janni0609/PsLoad/Hardware/Modul/PrezisoinPowerSupply 2_5/PrezisoinPowerSupply.kicad_pcb

## KiCad design Hardware/Modul/PrezisoinPowerSupply 2_5/PrezisoinPowerSupply.kicad_pcb (2026-03-17, last stored version)

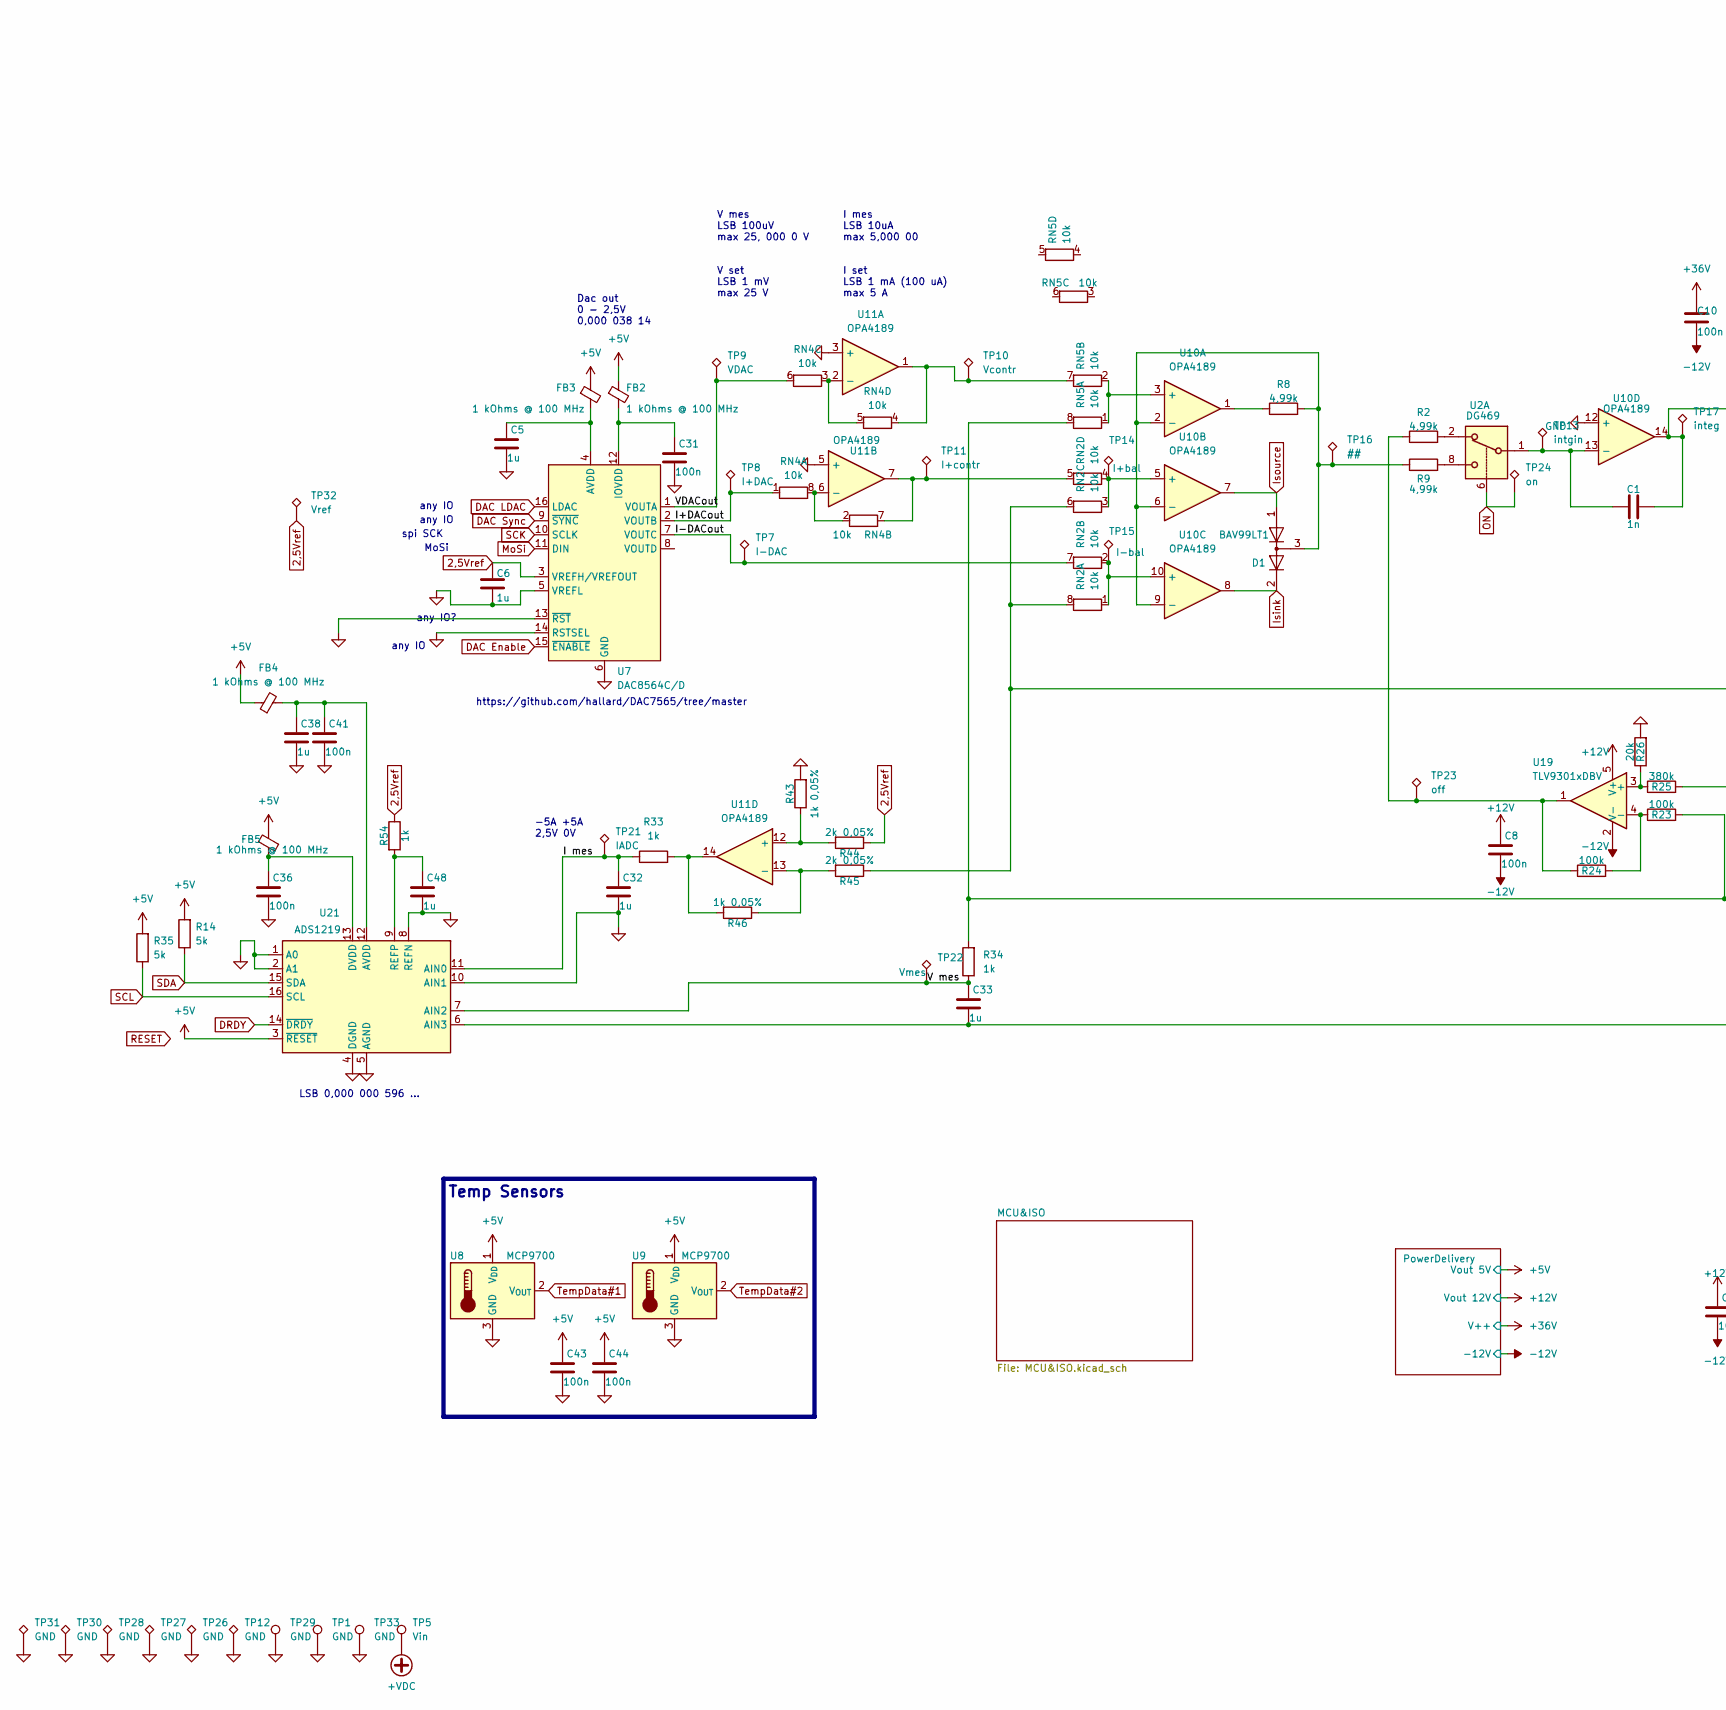
[picture p1: schematic PrezisoinPowerSupply.kicad_sch, PSLoad, part in row 1, column 1]

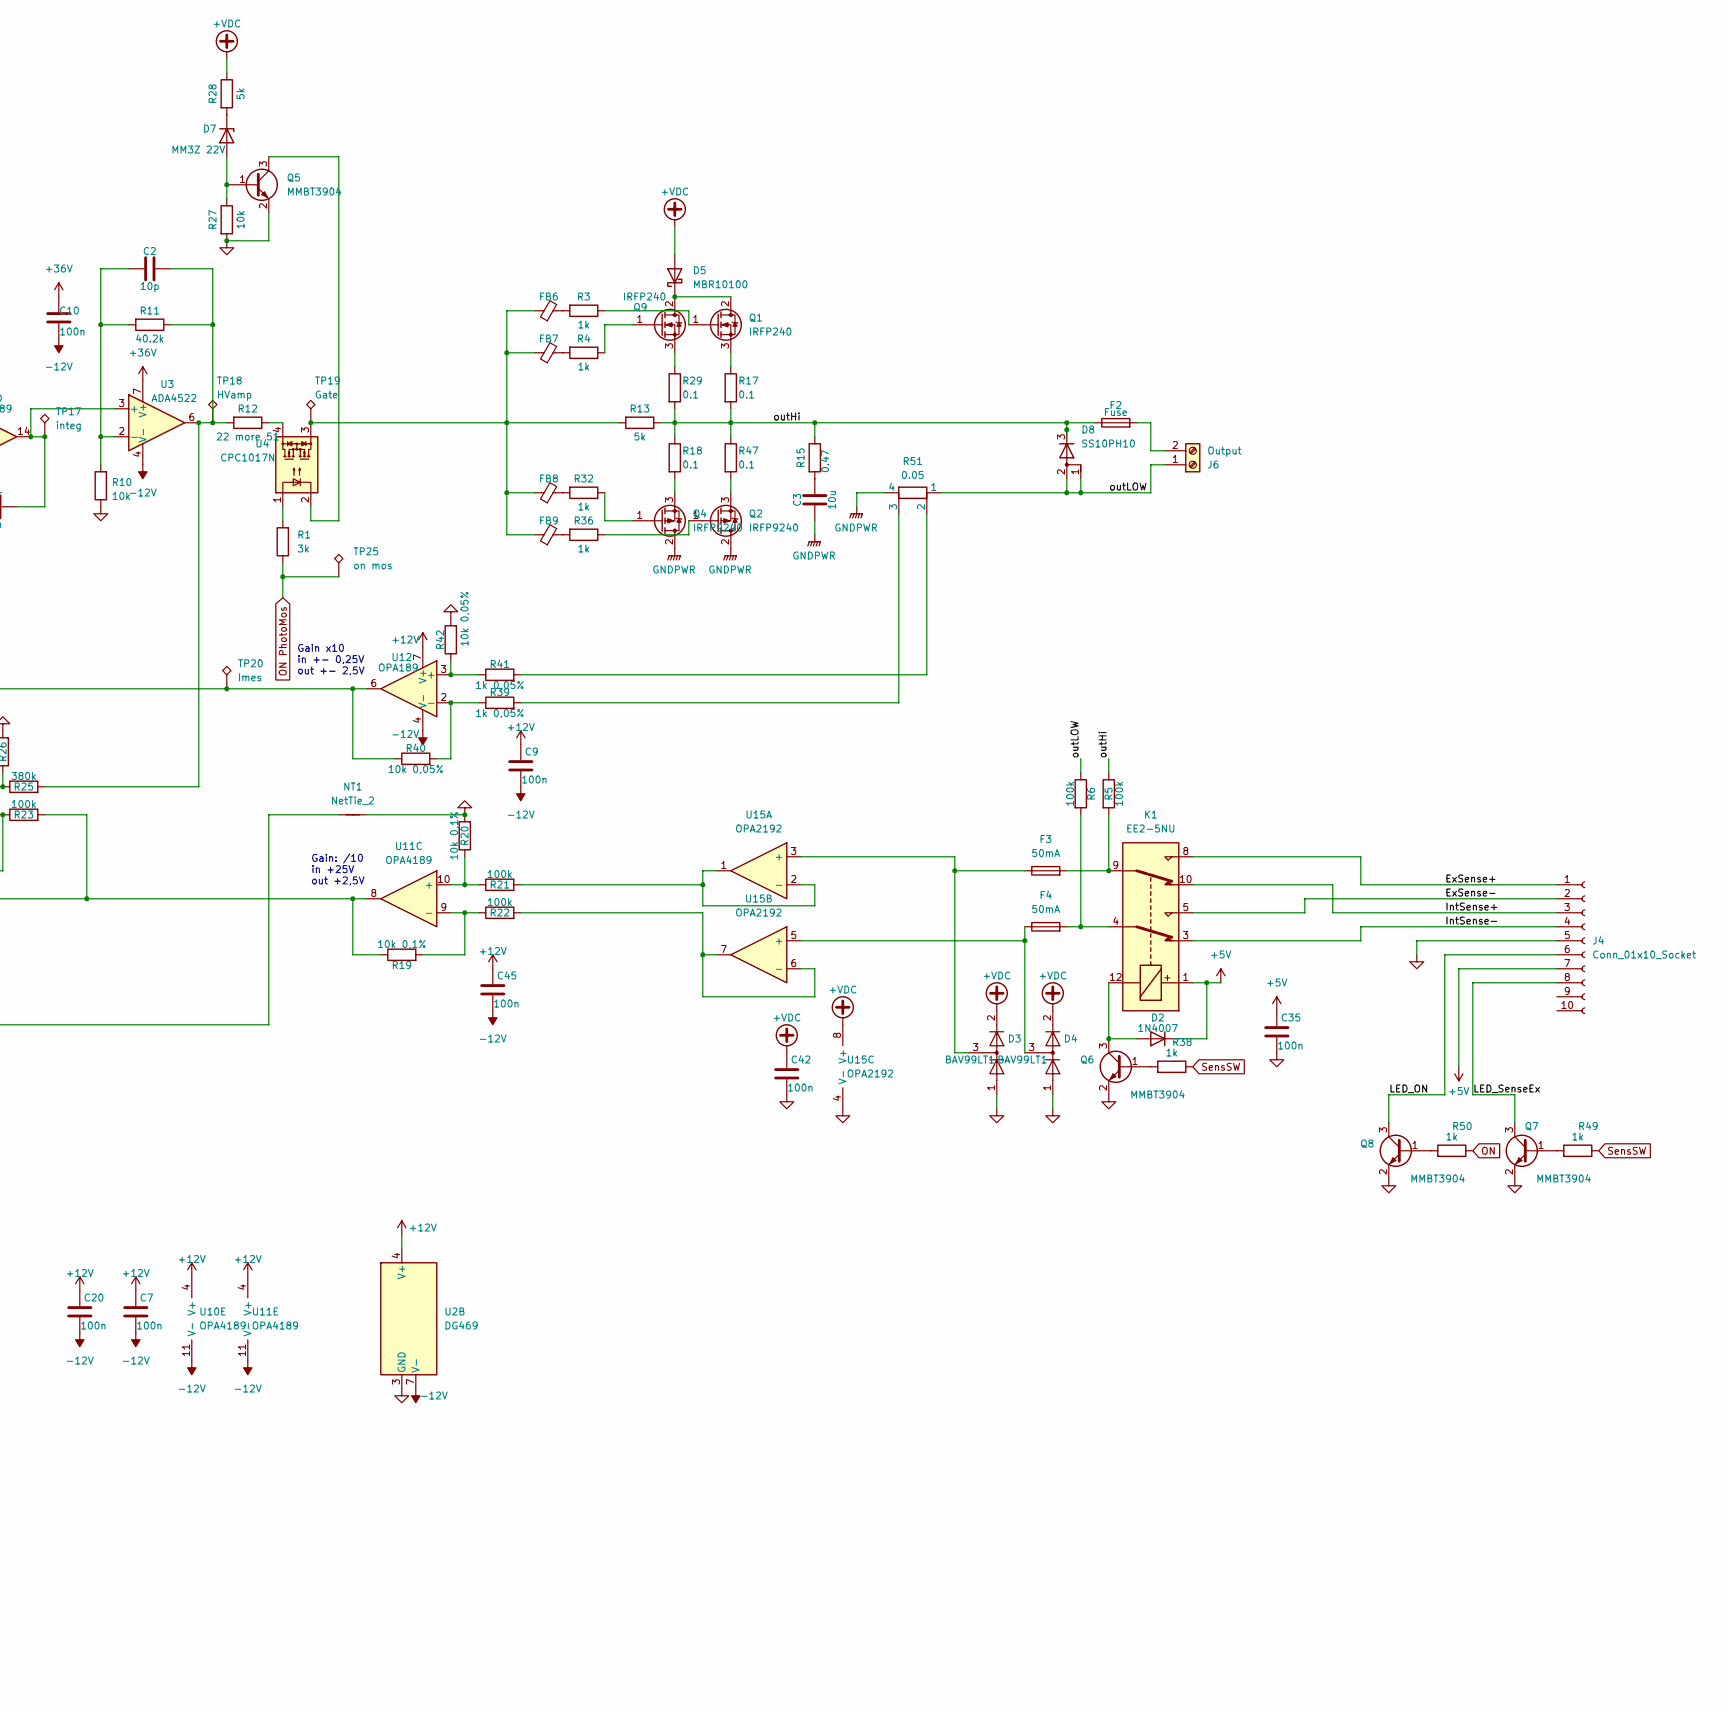
[picture p2: schematic PrezisoinPowerSupply.kicad_sch, PSLoad, part in row 1, column 2]

Parts:
C1: 1n; C_0603_1608Metric
C2: 10p; C_0603_1608Metric
C3: 10u; C_1206_3216Metric
C5, C6, C32, C33, C38, C48: 1u; C_0603_1608Metric
C7, C8, C9, C10, C20, C31, C35, C36, C41, C42, C43, C44, C45: 100n; C_0603_1608Metric
D1: BAV99LT1; SOT-23
D2: 1N4007; D_SOD-123F
D3, D4: BAV99LT1; SOT-23-3
D5: MBR10100; TO-220-2_Vertical
D7: MM3Z 22V; D_SOD-323F
D8: SS10PH10; TO-277A
F2: Fuse; Fuse_Littelfuse-NANO2-451_453
F3, F4: 50mA; Fuse_0402_1005Metric
FB2, FB3, FB4, FB5, FB6, FB7, FB8, FB9: 1 kOhms @ 100 MHz; L_0603_1608Metric
J4: Conn_01x10_Socket; JST_GH_BM10B-GHS-TBT_1x10-1MP_P1.25mm_Vertical
J6: Output; AMASS_XT30PW-F_1x02_P2.50mm_Horizontal
K1: EE2-5NU; Relay_DPDT_Kemet_EE2_NU
NT1: NetTie_2; NetTie-2_SMD_Pad0.5mm
Q1, Q9: IRFP240; TO-247-3_Vertical
Q2, Q4: IRFP9240; TO-247-3_Vertical
Q5, Q6, Q7, Q8: MMBT3904; SOT-23-3
R1: 3k; R_0603_1608Metric
R2, R8, R9: 4,99k; R_0603_1608Metric
R3, R4, R32, R33, R34, R36, R38, R49, R50, R54: 1k; R_0603_1608Metric
R5, R6, R21, R22, R23, R24: 100k; R_0603_1608Metric
R10, R27: 10k; R_0603_1608Metric
R11: 40.2k; R_0603_1608Metric
R12: 22 more 51; R_0603_1608Metric
R13, R14, R28, R35: 5k; R_0603_1608Metric
R15: 0.47; R_1206_3216Metric
R17, R18, R29, R47: 0.1; R_Bare_Metal_Element_L16.3mm_W4.8mm_P15.30mm
R19, R20: 10k 0,1%; R_0603_1608Metric
R25: 380k; R_0603_1608Metric
R26: 20k; R_0603_1608Metric
R39, R41, R43, R46: 1k 0,05%; R_0603_1608Metric
R40, R42: 10k 0,05%; R_0603_1608Metric
R44, R45: 2k 0,05%; R_0603_1608Metric
R51: 0.05; R 2728 4Wire
RN2, RN4, RN5: 10k; R_Array_Convex_4x0612
TP1, TP29, TP33: GND; SMD Test Point PCWCTE
TP5: Vin; SMD Test Point PCWCTE
TP7: I-DAC; TestPoint_Pad_D1.5mm
TP8: I+DAC; TestPoint_Pad_D1.5mm
TP9: VDAC; TestPoint_Pad_D1.5mm
TP10: Vcontr; TestPoint_Pad_D1.5mm
TP11: I+contr; TestPoint_Pad_D1.5mm
TP12, TP26, TP27, TP28, TP30, TP31: GND; TestPoint_Pad_D1.5mm
TP13: intgin; TestPoint_Pad_D1.5mm
TP14: I+bal; TestPoint_Pad_D1.5mm
TP15: I-bal; TestPoint_Pad_D1.5mm
TP16: ##; TestPoint_Pad_D1.5mm
TP17: integ; TestPoint_Pad_D1.5mm
TP18: HVamp; TestPoint_Pad_D1.5mm
TP19: Gate; TestPoint_Pad_D1.5mm
TP20: Imes; TestPoint_Pad_D1.5mm
TP21: IADC; TestPoint_Pad_D1.5mm
TP22: Vmes; TestPoint_Pad_D1.5mm
TP23: off; TestPoint_Pad_D1.5mm
TP24: on; TestPoint_Pad_D1.5mm
TP25: on mos; TestPoint_Pad_D1.5mm
TP32: Vref; TestPoint_Pad_D1.5mm
U2: DG469; SOIC-8_3.9x4.9mm_P1.27mm
U3: ADA4522; SOIC-8_3.9x4.9mm_P1.27mm
U4: CPC1017N; SOP-4_3.8x4.1mm_P2.54mm
U7: DAC8564C/D; TSSOP-16_4.4x5mm_P0.65mm
U8, U9: MCP9700; TO-92_Inline
U10, U11: OPA4189; SOIC-14_3.9x8.7mm_P1.27mm
U12: OPA189; SOIC-8_3.9x4.9mm_P1.27mm
U15: OPA2192; SOIC-8_3.9x4.9mm_P1.27mm
U19: TLV9301xDBV; SOT-23-5
U21: ADS1219; TSSOP-16_4.4x5mm_P0.65mm

Connections:
2,5Vref: C6.1, R44.1, R54.1, TP32.1, U7.3 (VREFH/VREFOUT)
+5V: C35.1, C43.1, C44.1, D2.1 (K), FB2.1, FB3.1, FB4.1, FB5.2, J4.7, K1.1, R14.2, R35.2, U8.1 (V_{DD}), U9.1 (V_{DD}), U21.3 (~RESET); also elsewhere on the board
+12V: C7.1, C8.1, C9.1, C20.1, C45.1, U2.4 (V+), U10.4 (V+), U11.4 (V+), U12.7 (V+), U19.5 (V+); also elsewhere on the board
+36V: C10.1, U3.7 (V+); also elsewhere on the board
-12V: C7.2, C8.2, C9.2, C10.2, C20.2, C45.2, U2.7 (V-), U3.4 (V-), U10.11 (V-), U11.11 (V-), U12.4 (V-), U19.2 (V-); also elsewhere on the board
/ExSense+: J4.1, K1.8
/ExSense-: J4.2, K1.5
/I mes: C32.1, R33.1, TP21.1, U21.11 (AIN0)
/I+DACout: RN4.1 (R1.1), TP8.1, U7.2 (VOUTB)
/I-DACout: RN2.7 (R2.2), TP7.1, U7.7 (VOUTC)
/IntSense+: J4.3, K1.10
/IntSense-: J4.4, K1.3
/LED_ON: J4.6, Q8.3 (C)
/LED_SenseEx: J4.8, Q7.3 (C)
/V mes: C33.1, R34.1, TP22.1, U21.7 (AIN2)
/VDACout: RN4.6 (R3.2), TP9.1, U7.1 (VOUTA)
/outHi: D8.3 (K), F2.1, R5.1, R13.1, R15.1, R17.2, R18.1, R29.2, R47.1
/outLOW: D8.1 (A), D8.2 (A), J6.1, R6.1, R51.1
DAC Enable: U7.15 (~ENABLE); also elsewhere on the board
DAC LDAC: U7.16 (LDAC); also elsewhere on the board
DAC Sync: U7.9 (~SYNC); also elsewhere on the board
DRDY: U21.14 (~DRDY); also elsewhere on the board
GND: C5.2, C6.2, C31.2, C32.2, C35.2, C36.2, C38.2, C41.2, C42.2, C43.2, C44.2, C48.2, D3.1 (K), D4.1 (K), J4.5, NT1.2, Q5.2 (E), Q6.2 (E), Q7.2 (E), Q8.2 (E), R10.1, R20.2, R26.2, R27.2, R42.2, R43.2, TP1.1, TP12.1, TP26.1, TP27.1, TP28.1, TP29.1, TP30.1, TP31.1, TP33.1, U2.3 (GND), U7.5 (VREFL), U7.6 (GND), U7.13 (~RST), U7.14 (RSTSEL), U8.3 (GND), U9.3 (GND), U10.12 (+), U11.3 (+), U11.5 (+), U15.4 (V-), U21.1 (A0), U21.2 (A1), U21.4 (DGND), U21.5 (AGND), U21.8 (REFN), U21.10 (AIN1); also elsewhere on the board
GNDPWR: C3.1, Q2.2 (D), Q4.2 (D), R51.4; also elsewhere on the board
Isink: D1.2 (A), U10.8
Isource: D1.1 (K), U10.7
MoSi: U7.11 (DIN); also elsewhere on the board
unnamed: C2.2, R11.1, R12.2, R25.2, TP18.1, U3.6
unnamed: C3.2, R15.2
unnamed: D2.2 (A), K1.12, Q6.3 (C)
unnamed: D5.1 (K), Q1.2 (D), Q9.2 (D)
unnamed: D7.2 (A), Q5.1 (B), R27.1
unnamed: D7.1 (K), R28.2
unnamed: F3.2, K1.9, R5.2
unnamed: F4.2, K1.4, R6.2
unnamed: FB6.1, FB7.1, FB8.1, FB9.1, R13.2, TP19.1, U4.3
unnamed: FB6.2, R3.2
unnamed: FB7.2, R4.2
unnamed: FB8.2, R32.2
unnamed: FB9.2, R36.2
unnamed: F2.2, J6.2
unnamed: Q1.1 (G), R3.1
unnamed: Q1.3 (S), R17.1
unnamed: Q2.1 (G), R36.1
unnamed: Q2.3 (S), R47.2
unnamed: Q4.1 (G), R32.1
unnamed: Q4.3 (S), R18.2
unnamed: Q5.3 (C), U4.2
unnamed: Q6.1 (B), R38.2
unnamed: Q7.1 (B), R49.2
unnamed: Q8.1 (B), R50.2
unnamed: Q9.1 (G), R4.1
unnamed: Q9.3 (S), R29.1
unnamed: R1.2, U4.1
unnamed: R2.1, R24.1, TP23.1, U19.1
unnamed: R2.2, U2.2
unnamed: R8.1, U10.1
unnamed: R9.2, U2.8
unnamed: R12.1, U4.4
unnamed: R33.2, R46.2, U11.14
unnamed: R39.2, R51.3
unnamed: R41.2, R51.2
unnamed: RN2.1 (R1.1), RN2.2 (R2.1), TP15.1, U10.10 (+)
unnamed: R40.1, R45.1, RN2.6 (R3.2), RN2.8 (R1.2), TP20.1, U12.6
unnamed: RN2.3 (R3.1), RN2.4 (R4.1), TP14.1, U10.5 (+)
unnamed: RN2.5 (R4.2), RN4.7 (R2.2), TP11.1, U11.7
unnamed: RN4.2 (R2.1), RN4.8 (R1.2), U11.6 (-)
unnamed: RN4.3 (R3.1), RN4.5 (R4.2), U11.2 (-)
unnamed: RN4.4 (R4.1), RN5.7 (R2.2), TP10.1, U11.1
unnamed: RN5.1 (R1.1), RN5.2 (R2.1), U10.3 (+)
unnamed: R19.1, R23.2, R34.2, RN5.8 (R1.2), U11.8
unnamed: C1.2, TP17.1, U3.3 (+), U10.14
unnamed: C2.1, R10.2, R11.2, U3.2 (-)
unnamed: C5.1, FB3.2, U7.4 (AVDD)
unnamed: C31.1, FB2.2, U7.12 (IOVDD)
unnamed: D1.3 (K), R8.2, R9.1, TP16.1, U10.2 (-), U10.6 (-), U10.9 (-)
unnamed: C1.1, TP13.1, U2.1, U10.13 (-)
unnamed: R20.1, R21.1, U11.10 (+)
unnamed: R19.2, R22.1, U11.9 (-)
unnamed: R43.1, R44.2, U11.12 (+)
unnamed: R45.2, R46.1, U11.13 (-)
unnamed: R41.1, R42.1, U12.3 (+)
unnamed: R39.1, R40.2, U12.2 (-)
unnamed: D3.3 (K), F3.1, U15.3 (+)
unnamed: R21.2, U15.1, U15.2 (-)
unnamed: D4.3 (K), F4.1, U15.5 (+)
unnamed: R22.2, U15.6 (-), U15.7
unnamed: R25.1, R26.1, U19.3 (+)
unnamed: R23.1, R24.2, U19.4 (-)
unnamed: C33.2, NT1.1, U21.6 (AIN3)
unnamed: C38.1, C41.1, FB4.2, U21.12 (AVDD)
unnamed: C36.1, FB5.1, U21.13 (DVDD)
unnamed: C48.1, R54.2, U21.9 (REFP)
ON: R50.1, TP24.1, U2.6; also elsewhere on the board
ON PhotoMos: R1.1, TP25.1; also elsewhere on the board
SCK: U7.10 (SCLK); also elsewhere on the board
SCL: R35.1, U21.16 (SCL); also elsewhere on the board
SDA: R14.1, U21.15 (SDA); also elsewhere on the board
SensSW: R38.1, R49.1; also elsewhere on the board
TempData#1: U8.2 (V_{OUT}); also elsewhere on the board
TempData#2: U9.2 (V_{OUT}); also elsewhere on the board

Notes on the sheet:
https://github.com/hallard/DAC7565/tree/master
any IO
Temp Sensors
Dac out 0 - 2,5V 0,000 038 14
LSB 0,000 000 596 ...
spi SCK
any IO?
Gain: /10 in +25V out +2,5V
MoSi
-5A +5A 2,5V 0V
V mes LSB 100uV max 25, 000 0 V
V set LSB 1 mV max 25 V
Gain x10 in +- 0,25V out +- 2,5V
I mes LSB 10uA max 5,000 00
I set LSB 1 mA (100 uA) max 5 A

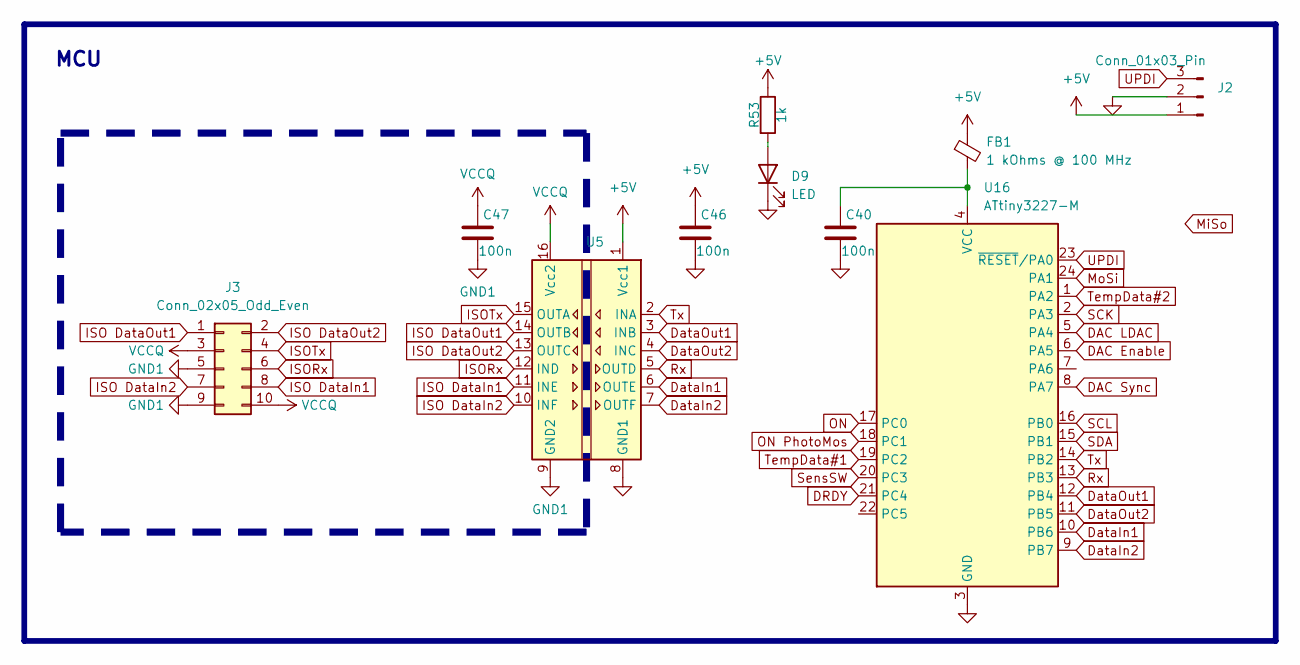
[picture p3: schematic MCU&ISO.kicad_sch]

Parts:
C40, C46, C47: 100n; C_0603_1608Metric
D9: LED; LED_0603_1608Metric
FB1: 1 kOhms @ 100 MHz; L_0603_1608Metric
J2: Conn_01x03_Pin; PinSocket_1x03_P2.54mm_Vertical
J3: Conn_02x05_Odd_Even; IDC-Header_2x05_P2.54mm_Vertical
R53: 1k; R_0603_1608Metric
U5: ISO7763FDBQ; SSOP-16_3.9x4.9mm_P0.635mm
U16: ATtiny3227-M; QFN-24-1EP_4x4mm_P0.5mm_EP2.6x2.6mm

Connections:
+5V: C46.1, FB1.1, J2.1, R53.1, U5.1 (Vcc1); also elsewhere on the board
DAC Enable: U16.6 (PA5); also elsewhere on the board
DAC LDAC: U16.5 (PA4); also elsewhere on the board
DAC Sync: U16.8 (PA7); also elsewhere on the board
DRDY: U16.21 (PC4); also elsewhere on the board
DataIn1: U5.6 (OUTE), U16.10 (PB6)
DataIn2: U5.7 (OUTF), U16.9 (PB7)
DataOut1: U5.3 (INB), U16.12 (PB4)
DataOut2: U5.4 (INC), U16.11 (PB5)
GND: C40.2, C46.2, D9.1 (K), J2.2, U5.8 (GND1), U16.3 (GND), U16.25 (GND); also elsewhere on the board
GND1: C47.2, J3.5, J3.9, U5.9 (GND2)
ISO DataIn1: J3.8, U5.11 (INE)
ISO DataIn2: J3.7, U5.10 (INF)
ISO DataOut1: J3.1, U5.14 (OUTB)
ISO DataOut2: J3.2, U5.13 (OUTC)
ISORx: J3.6, U5.12 (IND)
ISOTx: J3.4, U5.15 (OUTA)
MoSi: U16.24 (PA1); also elsewhere on the board
unnamed: D9.2 (A), R53.2
unnamed: C40.1, FB1.2, U16.4 (VCC)
ON: U16.17 (PC0); also elsewhere on the board
ON PhotoMos: U16.18 (PC1); also elsewhere on the board
Rx: U5.5 (OUTD), U16.13 (PB3)
SCK: U16.2 (PA3); also elsewhere on the board
SCL: U16.16 (PB0); also elsewhere on the board
SDA: U16.15 (PB1); also elsewhere on the board
SensSW: U16.20 (PC3); also elsewhere on the board
TempData#1: U16.19 (PC2); also elsewhere on the board
TempData#2: U16.1 (PA2); also elsewhere on the board
Tx: U5.2 (INA), U16.14 (PB2)
UPDI: J2.3, U16.23 (~RESET/PA0)
VCCQ: C47.1, J3.3, J3.10, U5.16 (Vcc2)

Notes on the sheet:
MCU

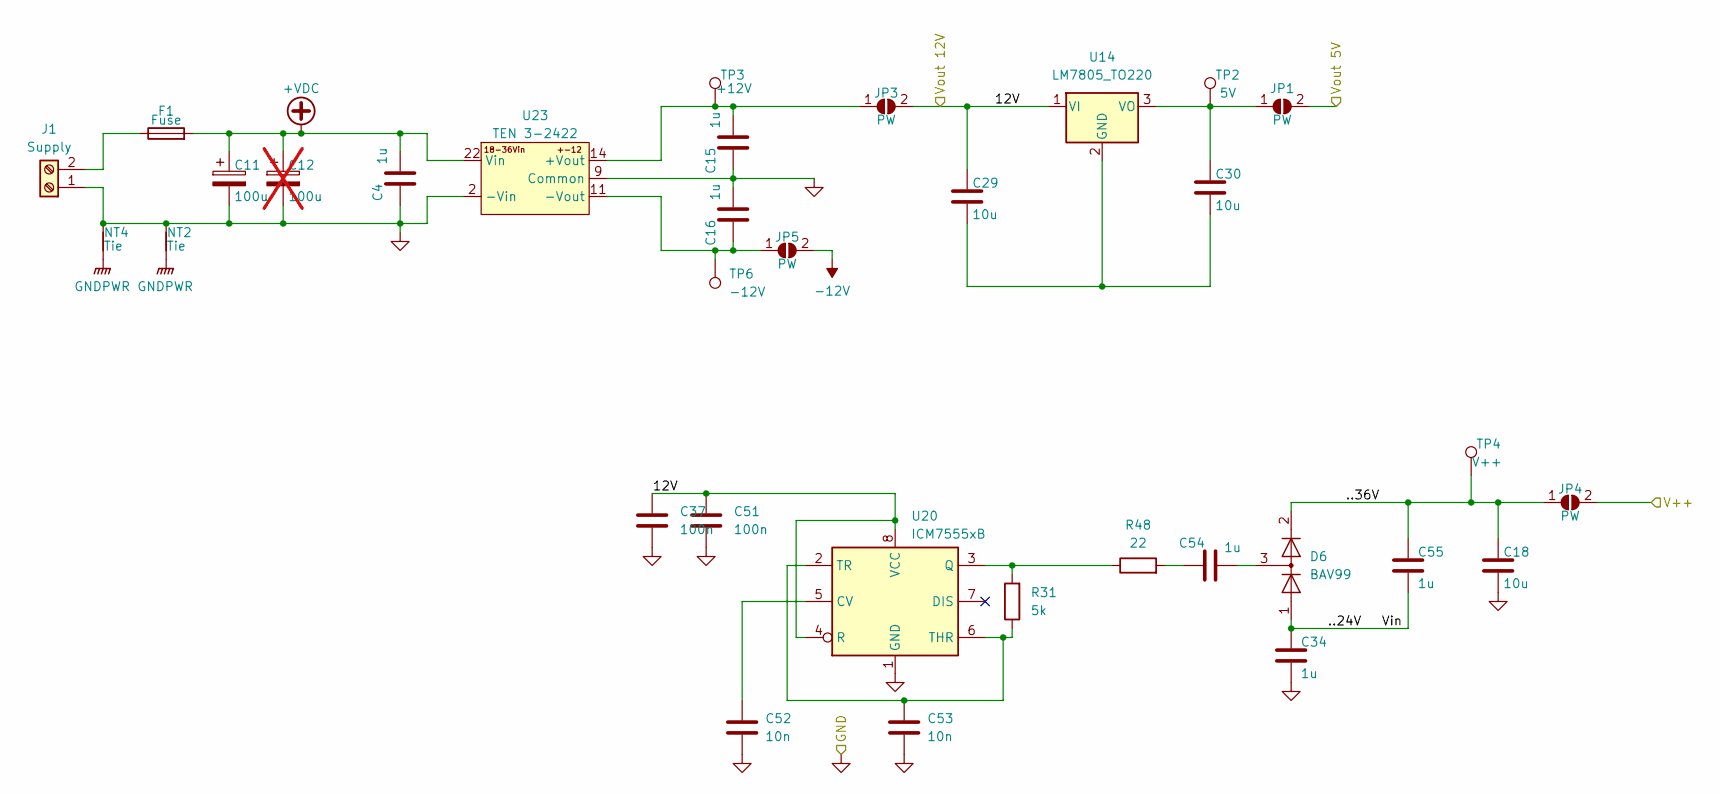
[picture p4: schematic PowerDel.kicad_sch]

Parts:
C4, C15, C16, C34, C54, C55: 1u; C_1206_3216Metric
C11: 100u; CP_Elec_8x10.5
C12: 100u; CP_Elec_8x10.5; not fitted
C18, C29, C30: 10u; C_1206_3216Metric
C37, C51: 100n; C_0603_1608Metric
C52, C53: 10n; C_0603_1608Metric
D6: BAV99; SOT-23-3
F1: Fuse; Fuse_Littelfuse-NANO2-451_453
J1: Supply; AMASS_XT30PW-M_1x02_P2.50mm_Horizontal
JP1, JP3, JP4, JP5: PW; SolderJumper-2_P1.3mm_Open_RoundedPad1.0x1.5mm
NT2, NT4: Tie; NetTie-2_SMD_Pad2.0mm
R31: 5k; R_0603_1608Metric
R48: 22; R_0603_1608Metric
TP2: 5V; SMD Test Point PCWCTE
TP3: +12V; SMD Test Point PCWCTE
TP4: V++; SMD Test Point PCWCTE
TP6: -12V; SMD Test Point PCWCTE
U14: LM7805_TO220; TO-220-3_Vertical
U20: ICM7555xB; SOIC-8_3.9x4.9mm_P1.27mm
U23: TEN 3-2422; Traco TEN 3-2422

Connections:
+5V: JP1.2 (B); also elsewhere on the board
+12V: C29.1, C37.1, C51.1, JP3.2 (B), U14.1 (VI), U20.4 (R), U20.8 (VCC); also elsewhere on the board
+36V: JP4.2 (B); also elsewhere on the board
-12V: JP5.2 (B); also elsewhere on the board
/PowerDelivery/..36V: C18.1, C55.1, D6.2 (A), JP4.1 (A), TP4.1
GND: C4.1, C11.2, C12.2, C15.1, C16.2, C18.2, C34.2, C37.2, C51.2, C52.2, C53.2, J1.1, NT2.2, NT4.2, U20.1 (GND), U23.2 (-Vin), U23.3 (-Vin), U23.9 (Common), U23.16 (Common); also elsewhere on the board
GNDPWR: NT2.1, NT4.1; also elsewhere on the board
unnamed: C54.1, R48.2
unnamed: C54.2, D6.3 (K)
unnamed: F1.1, J1.2
unnamed: C30.1, JP1.1 (A), TP2.1, U14.3 (VO)
unnamed: C15.2, JP3.1 (A), TP3.1, U23.14 (+Vout)
unnamed: C16.1, JP5.1 (A), TP6.1, U23.11 (-Vout)
unnamed: C29.2, C30.2, U14.2 (GND)
unnamed: C52.1, U20.5 (CV)
unnamed: R31.2, R48.1, U20.3 (Q)
unnamed: C53.1, R31.1, U20.2 (TR), U20.6 (THR)

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
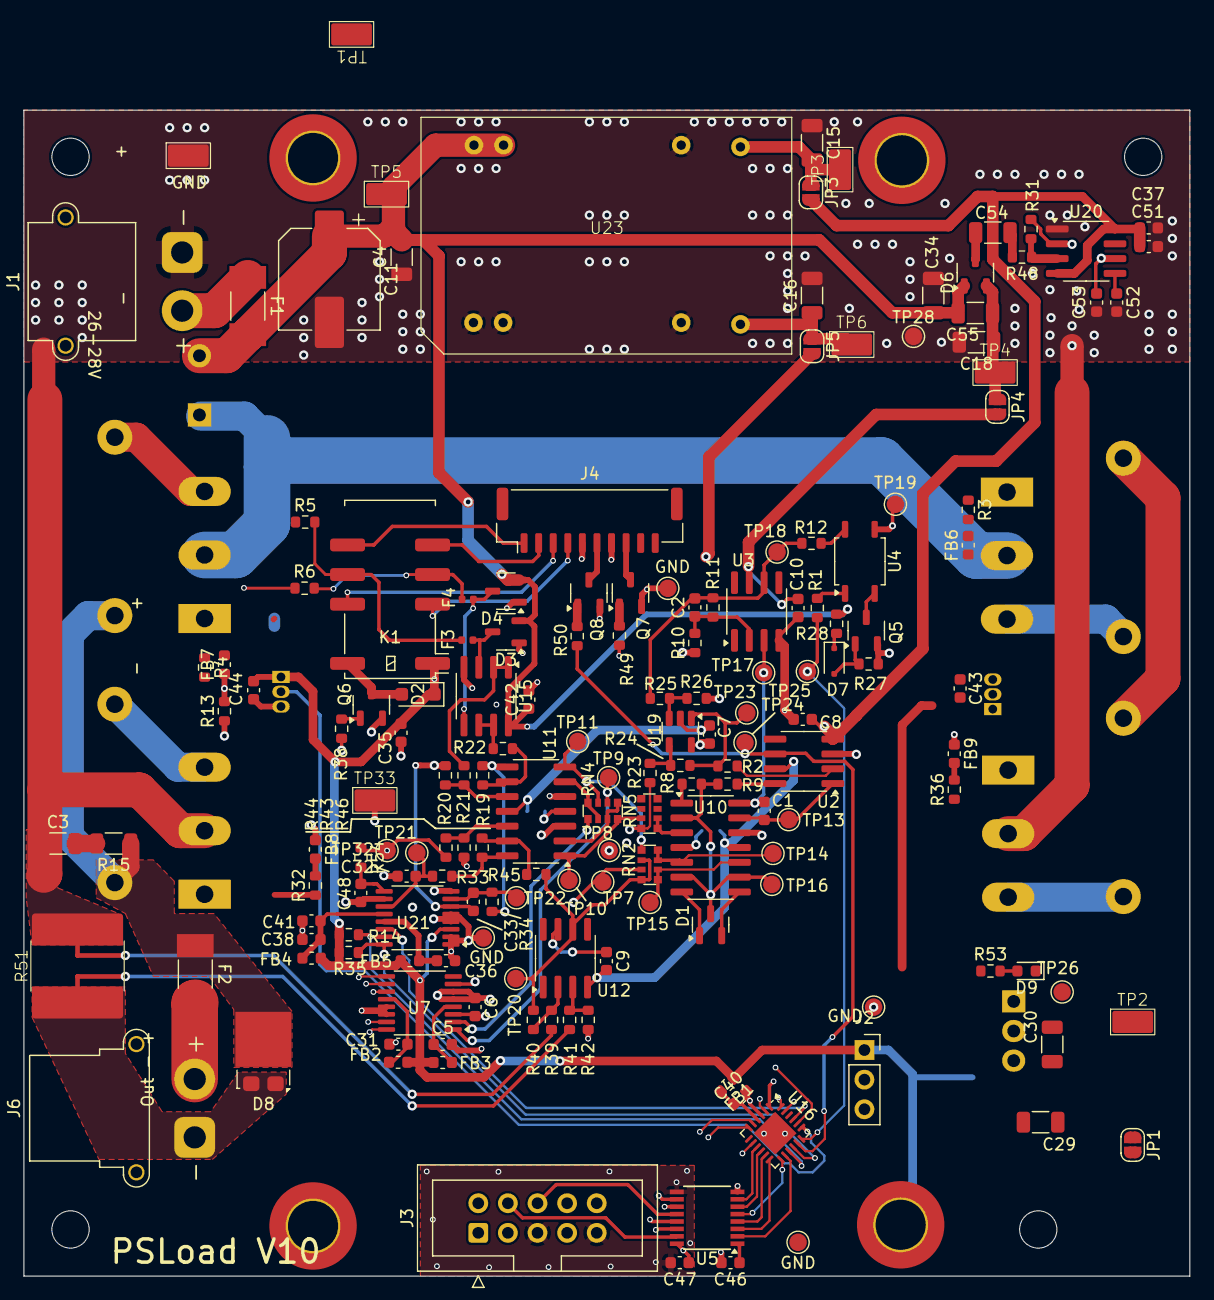
[picture p5: board PrezisoinPowerSupply.kicad_pcb from above]

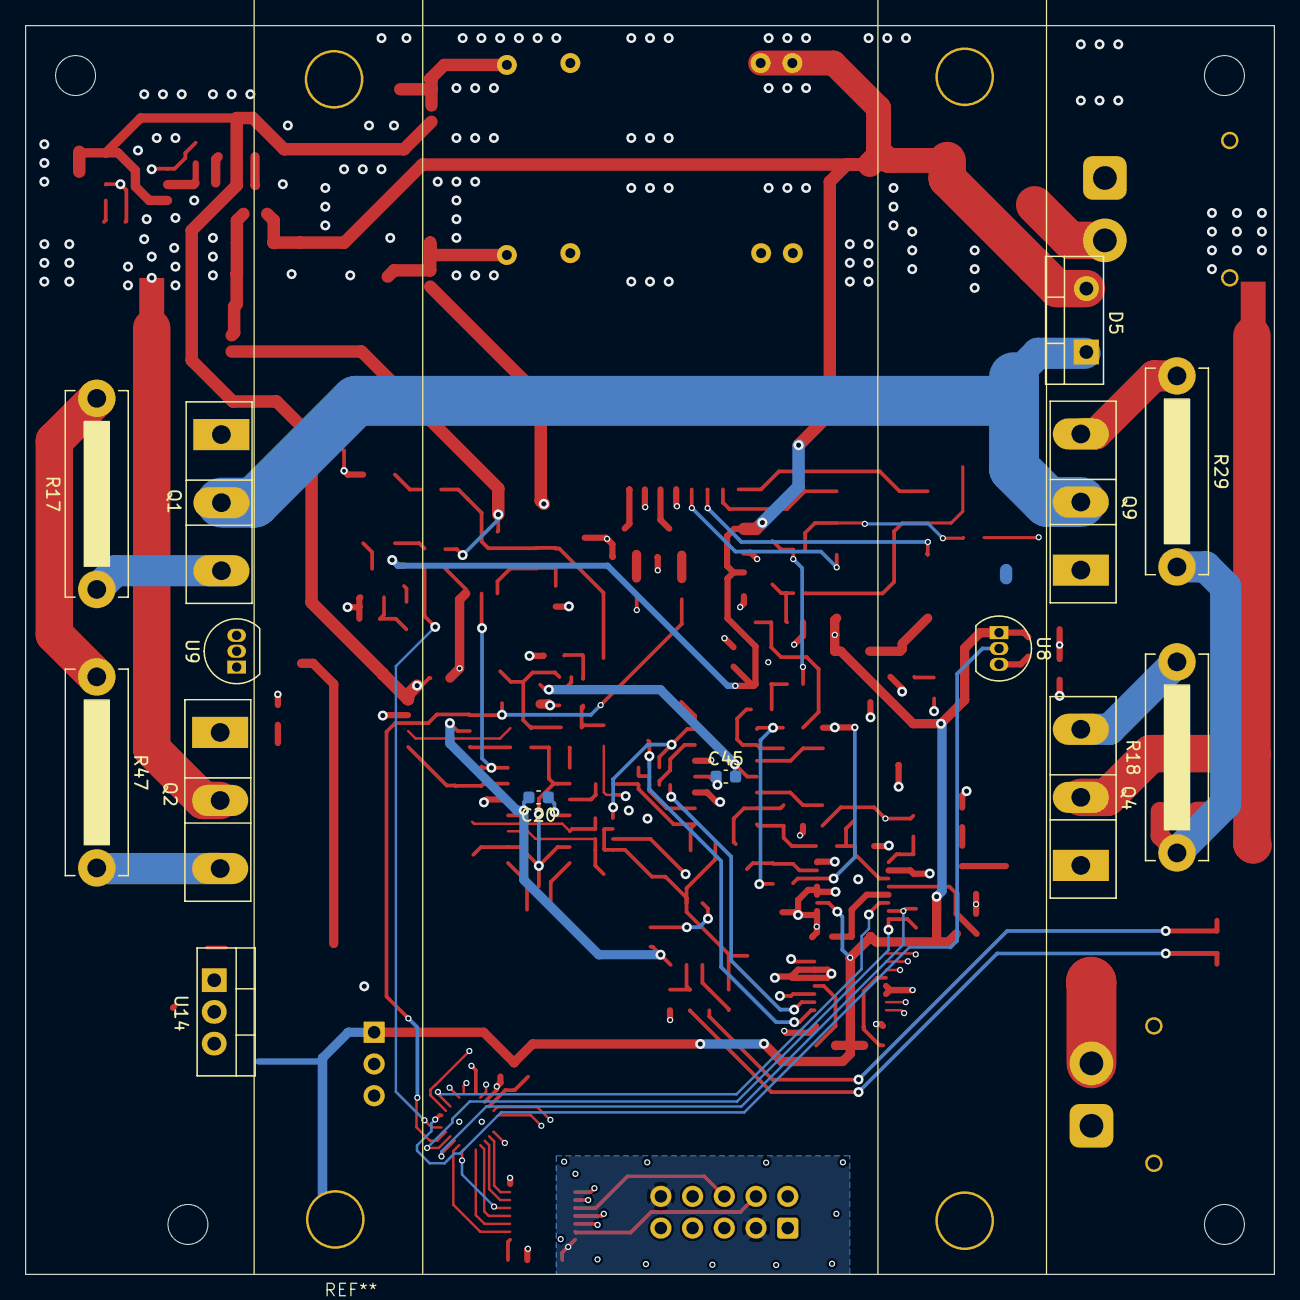
[picture p6: board PrezisoinPowerSupply.kicad_pcb from below]

Board: 4 copper layers, 100.0 x 100.0 mm, 184 parts (14 on the bottom side), 130 nets.
