janni0609/PsLoad/Hardware/ForntDist/FrontDirstreb_V2_0/FrontDirstreb.kicad_pcb

## KiCad design Hardware/ForntDist/FrontDirstreb_V2_0/FrontDirstreb.kicad_pcb (2025-06-24, last stored version)

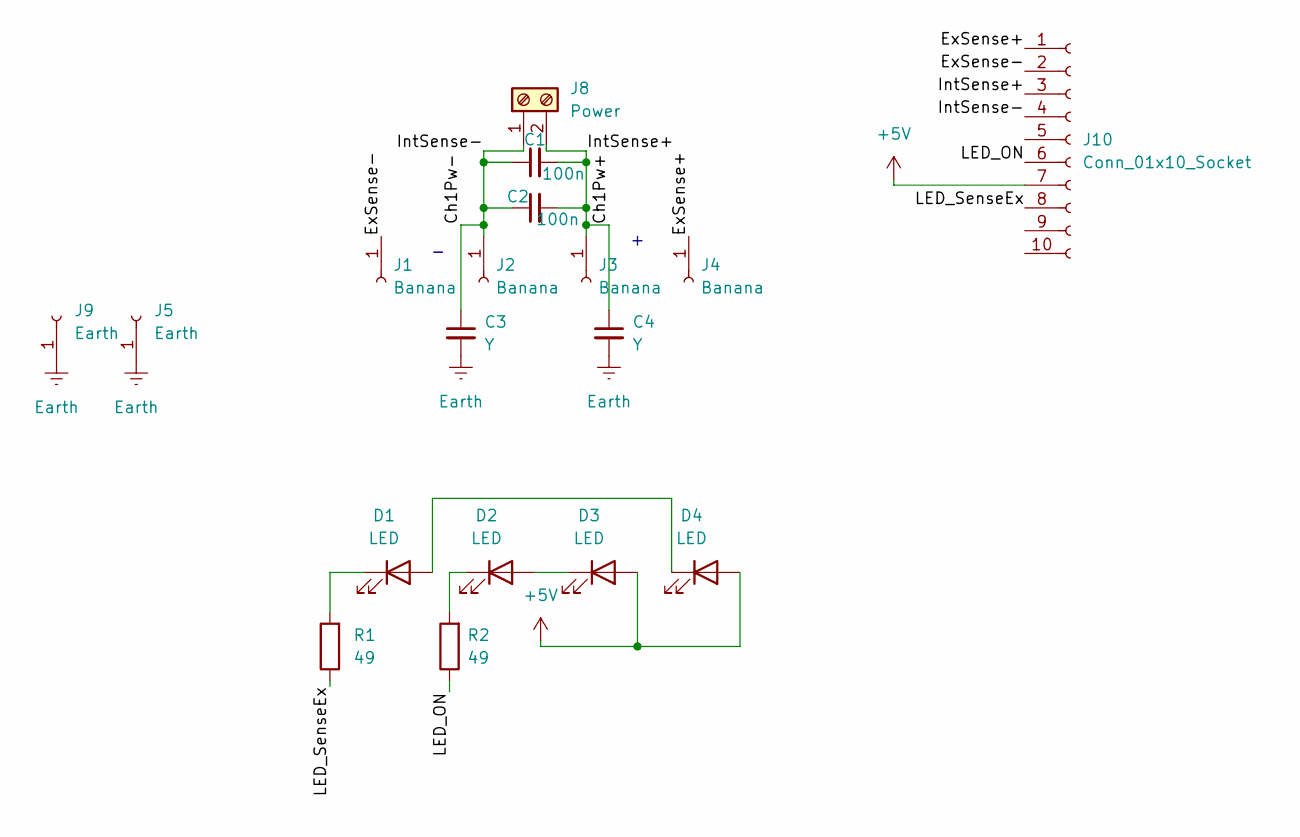
[picture p7: schematic FrontDirstreb.kicad_sch]

Parts:
C1, C2: 100n; C_1206_3216Metric
C3, C4: Y; C_Rect_L13.0mm_W4.0mm_P10.00mm_FKS3_FKP3_MKS4
D1, D2, D3, D4: LED; LED_D3.0mm_FlatTop
J1, J2, J3, J4: Banana; BananaSocket
J5, J9: Earth; SolderWire-1.5sqmm_1x01_D1.7mm_OD3.9mm
J8: Power; AMASS_XT30PW-M_1x02_P2.50mm_Horizontal
J10: Conn_01x10_Socket; JST_GH_BM10B-GHS-TBT_1x10-1MP_P1.25mm_Vertical
R1, R2: 49; R_0603_1608Metric

Connections:
+5V: D3.2 (A), D4.2 (A), J10.7
/Ch1Pw+: C1.2, C2.2, C4.1, J3.1, J8.2, J10.3
/Ch1Pw-: C1.1, C2.1, C3.1, J2.1, J8.1, J10.4
/ExSense+: J4.1, J10.1
/ExSense-: J1.1, J10.2
/LED_ON: J10.6, R2.1
/LED_SenseEx: J10.8, R1.1
Earth: C3.2, C4.2, J5.1, J9.1
unnamed: D1.2 (A), D4.1 (K)
unnamed: D1.1 (K), R1.2
unnamed: D2.2 (A), D3.1 (K)
unnamed: D2.1 (K), R2.2

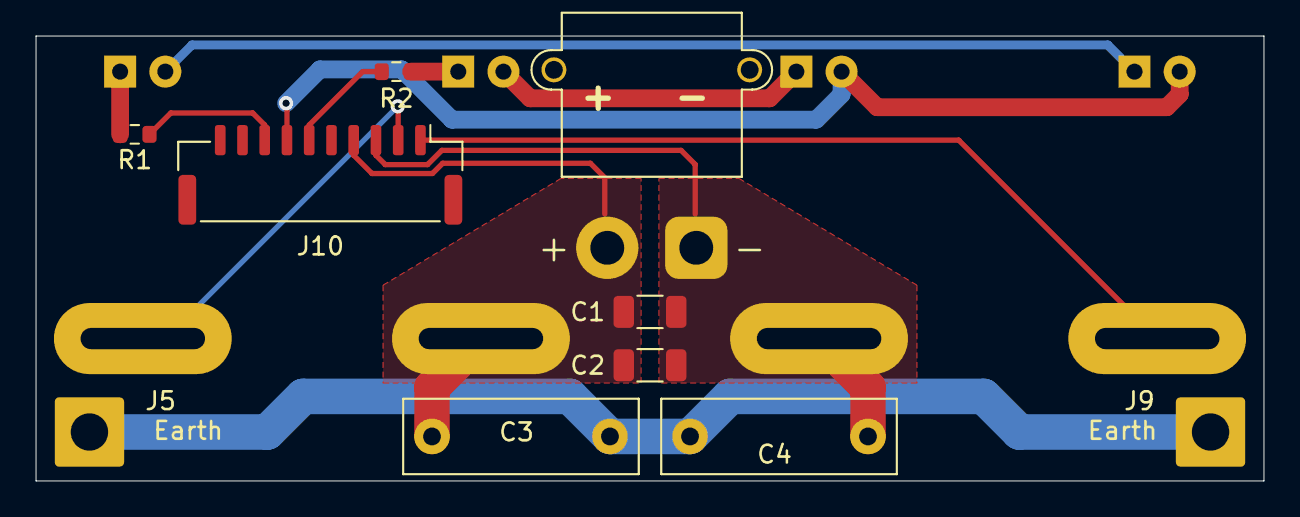
[picture p8: board FrontDirstreb.kicad_pcb from above]

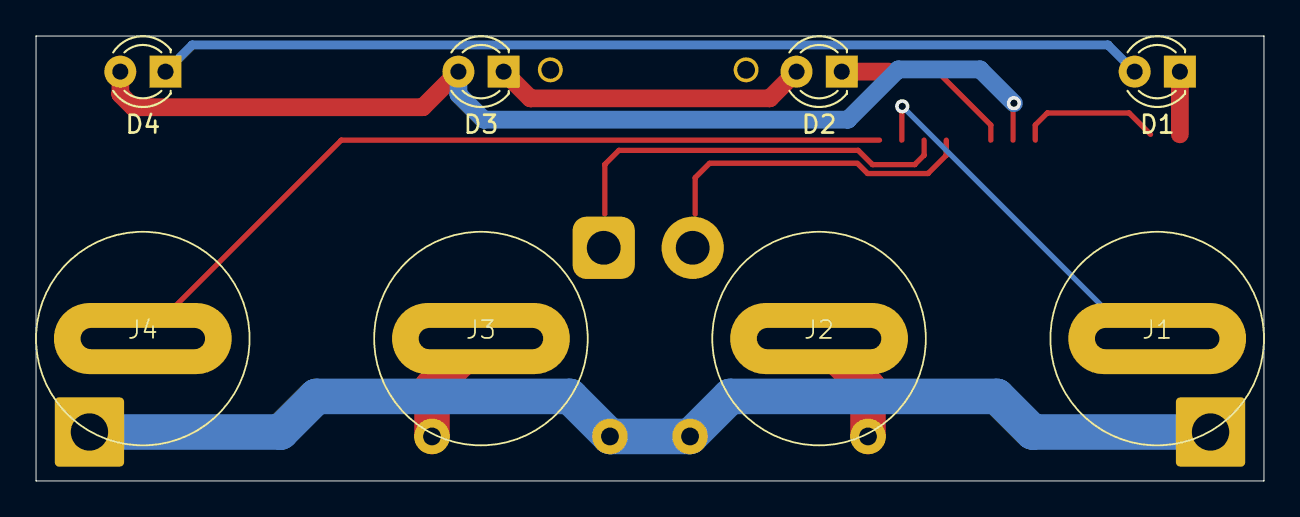
[picture p9: board FrontDirstreb.kicad_pcb from below]

Board: 2 copper layers, 69.0 x 25.0 mm, 18 parts (8 on the bottom side), 12 nets.
