janni0609/PsLoad/Hardware/BeeperAddOn/BeeperAddOn.kicad_pcb

## KiCad design Hardware/BeeperAddOn/BeeperAddOn.kicad_pcb (2024-05-20, last stored version)

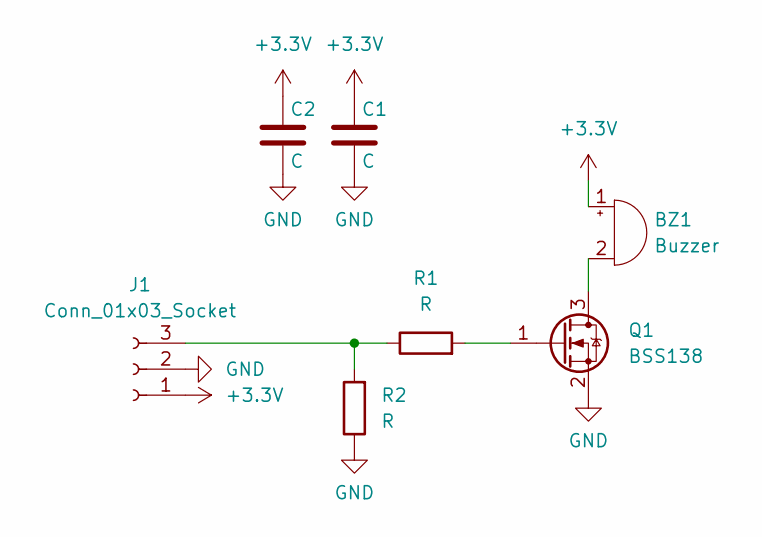
[picture p10: schematic BeeperAddOn.kicad_sch]

Parts:
BZ1: Buzzer; Buzzer_12x9.5RM7.6
C1, C2: C; C_0603_1608Metric
J1: Conn_01x03_Socket; PinSocket_1x03_P2.54mm_Vertical
Q1: BSS138; SOT-23-3
R1, R2: R; R_0603_1608Metric

Connections:
+3.3V: BZ1.1 (+), C1.1, C2.1, J1.1
GND: C1.2, C2.2, J1.2, Q1.2 (S), R2.1
unnamed: BZ1.2 (-), Q1.3 (D)
unnamed: J1.3, R1.1, R2.2
unnamed: Q1.1 (G), R1.2

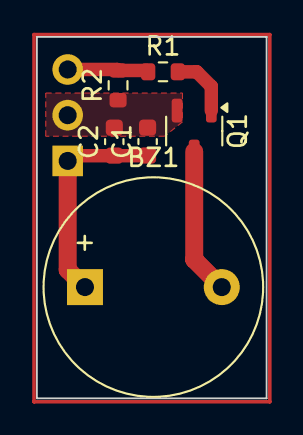
[picture p11: board BeeperAddOn.kicad_pcb from above]

Board: 2 copper layers, 12.8 x 20.1 mm, 7 parts (1 on the bottom side), 5 nets.
