janni0609/PsLoad/Hardware/PreciPSLoadFront V3/PreciPSLoadFront.kicad_pcb

## KiCad design Hardware/PreciPSLoadFront V3/PreciPSLoadFront.kicad_pcb (2024-05-15, last stored version)

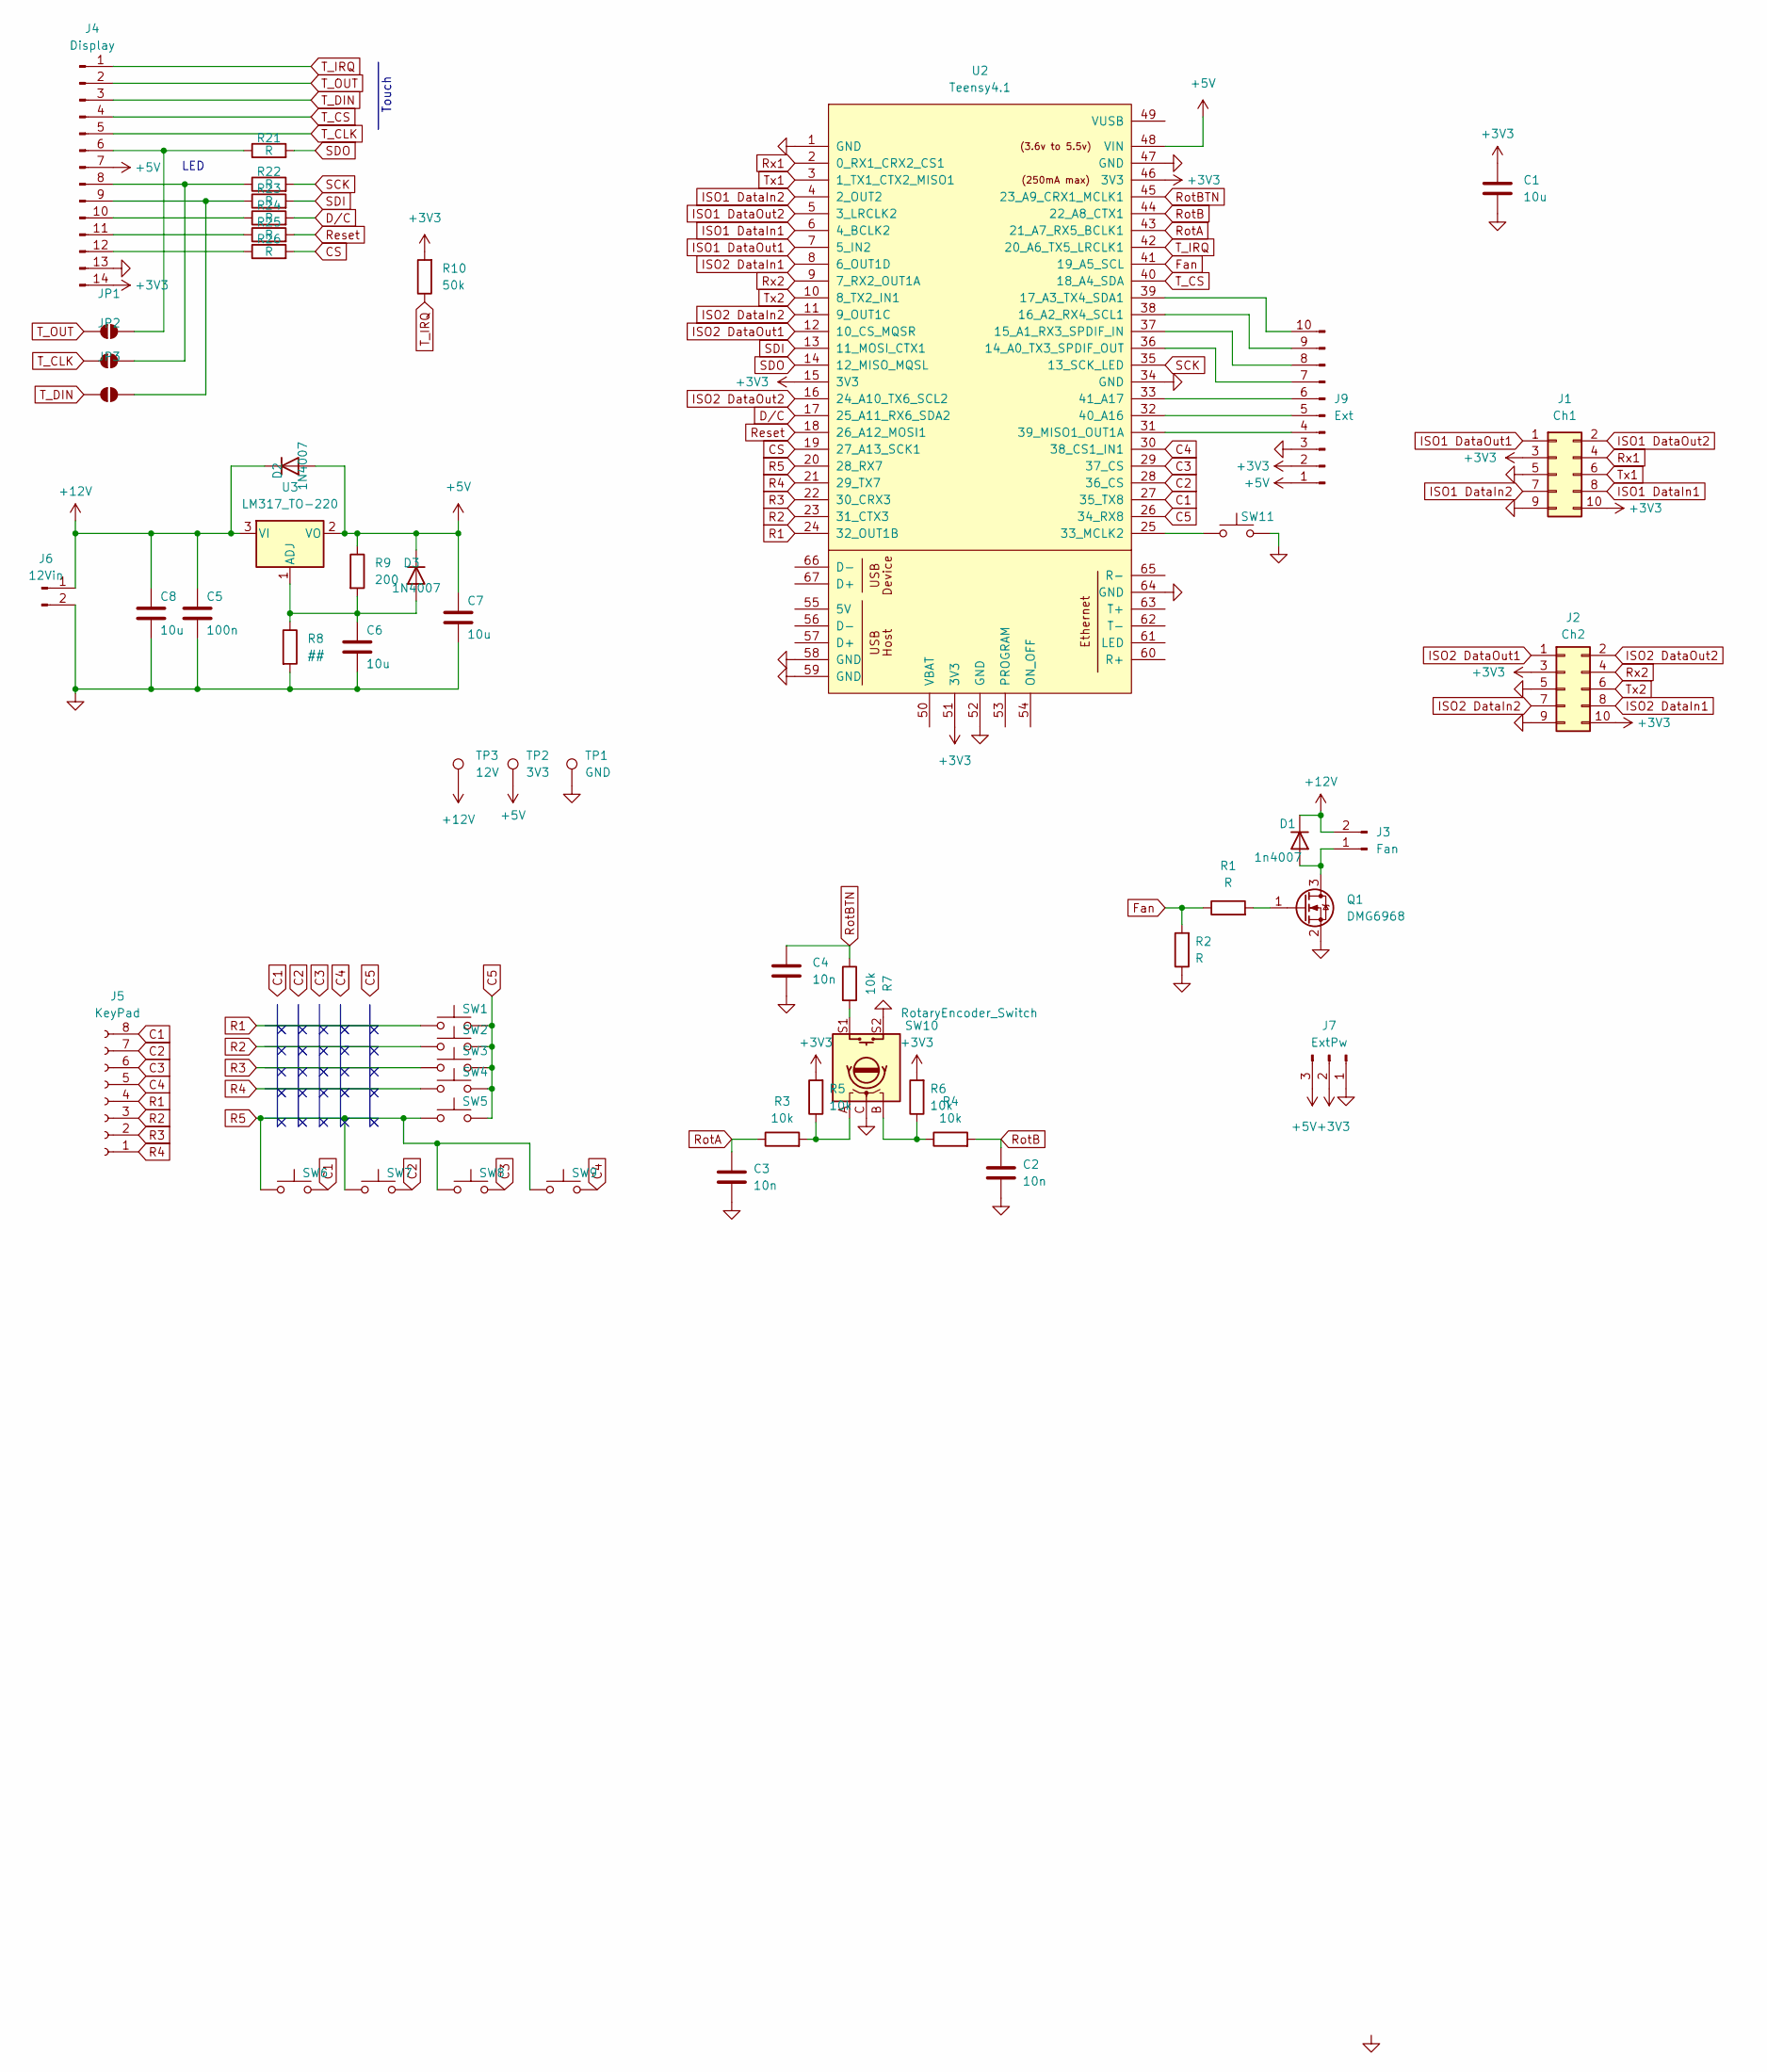
[picture p12: schematic PreciPSLoadFront.kicad_sch]

Parts:
C1, C6, C7, C8: 10u; C_1206_3216Metric
C2, C3, C4: 10n; C_0603_1608Metric
C5: 100n; C_1206_3216Metric
D1: 1n4007; D_SOD-123F
D2, D3: 1N4007; D_SOD-123F
J1: Ch1; IDC-Header_2x05_P2.54mm_Vertical
J2: Ch2; IDC-Header_2x05_P2.54mm_Vertical
J3: Fan; JST_XH_B2B-XH-A_1x02_P2.50mm_Vertical
J4: Display; PinSocket_1x14_P2.54mm_Vertical
J5: KeyPad; PinSocket_1x08_P2.54mm_Vertical
J6: 12Vin; JST_XH_B2B-XH-A_1x02_P2.50mm_Vertical
J7: ExtPw; JST_XH_B3B-XH-A_1x03_P2.50mm_Vertical
J9: Ext; PinHeader_1x10_P2.54mm_Vertical
JP1, JP2, JP3: SolderJumper_2_Open; SolderJumper-2_P1.3mm_Open_TrianglePad1.0x1.5mm
Q1: DMG6968; SOT-23-3
R1, R2, R21, R22, R23, R24, R25, R26: R; R_0603_1608Metric
R3, R4, R5, R6, R7: 10k; R_0603_1608Metric
R8: ##; R_0603_1608Metric
R9: 200; R_0603_1608Metric
R10: 50k; R_0603_1608Metric
SW1, SW2, SW3, SW4, SW5, SW6, SW7, SW8, SW9, SW11: SW_Push; Panel Push Btn
SW10: RotaryEncoder_Switch; RotaryEncoder_Bourns_Vertical_PEC12R-3x17F-Sxxxx
TP1: GND; SMD Test Point PCWCTE
TP2: 3V3; SMD Test Point PCWCTE
TP3: 12V; SMD Test Point PCWCTE
U2: Teensy4.1; Teensy41
U3: LM317_TO-220; TO-220-3_Vertical

Connections:
+3V3: C1.1, J1.3, J1.10, J2.3, J2.10, J4.14, J7.2, J9.2, R5.2, R6.2, R10.2, U2.15 (3V3), U2.46 (3V3), U2.51 (3V3)
+5V: C7.1, D2.2 (A), D3.1 (K), J4.7, J7.3, J9.1, R9.1, TP2.1, U2.48 (VIN), U3.2 (VO)
+12V: C5.1, C8.1, D1.1 (K), D2.1 (K), J3.2, J6.1, TP3.1, U3.3 (VI)
C1: J5.8, SW6.2, U2.27 (35_TX8)
C2: J5.7, SW7.2, U2.28 (36_CS)
C3: J5.6, SW8.2, U2.29 (37_CS)
C4: J5.5, SW9.2, U2.30 (38_CS1_IN1)
C5: SW1.2, SW2.2, SW3.2, SW4.2, SW5.2, U2.26 (34_RX8)
CS: R26.2, U2.19 (27_A13_SCK1)
D/C: R24.2, U2.17 (25_A11_RX6_SDA2)
Fan: R1.1, R2.2, U2.41 (19_A5_SCL)
GND: C1.2, C2.1, C3.1, C4.2, C5.2, C6.2, C7.2, C8.2, J1.5, J1.9, J2.5, J2.9, J4.13, J6.2, J7.1, J9.3, Q1.2 (S), R2.1, R8.2, SW10.C, SW10.S2, SW11.2, TP1.1, U2.1 (GND), U2.34 (GND), U2.47 (GND), U2.52 (GND), U2.58 (GND), U2.59 (GND), U2.64 (GND)
ISO1 DataIn1: J1.8, U2.6 (4_BCLK2)
ISO1 DataIn2: J1.7, U2.4 (2_OUT2)
ISO1 DataOut1: J1.1, U2.7 (5_IN2)
ISO1 DataOut2: J1.2, U2.5 (3_LRCLK2)
ISO2 DataIn1: J2.8, U2.8 (6_OUT1D)
ISO2 DataIn2: J2.7, U2.11 (9_OUT1C)
ISO2 DataOut1: J2.1, U2.12 (10_CS_MQSR)
ISO2 DataOut2: J2.2, U2.16 (24_A10_TX6_SCL2)
unnamed: D1.2 (A), J3.1, Q1.3 (D)
unnamed: C6.1, D3.2 (A), R8.1, R9.2, U3.1 (ADJ)
unnamed: J4.6, JP1.2 (B), R21.1
unnamed: J4.8, JP2.2 (B), R22.1
unnamed: J4.9, JP3.2 (B), R23.1
unnamed: J4.10, R24.1
unnamed: J4.11, R25.1
unnamed: J4.12, R26.1
unnamed: J9.4, U2.31 (39_MISO1_OUT1A)
unnamed: J9.5, U2.32 (40_A16)
unnamed: J9.6, U2.33 (41_A17)
unnamed: J9.7, U2.36 (14_A0_TX3_SPDIF_OUT)
unnamed: J9.8, U2.37 (15_A1_RX3_SPDIF_IN)
unnamed: J9.9, U2.38 (16_A2_RX4_SCL1)
unnamed: J9.10, U2.39 (17_A3_TX4_SDA1)
unnamed: Q1.1 (G), R1.2
unnamed: R3.2, R5.1, SW10.A
unnamed: R4.1, R6.1, SW10.B
unnamed: R7.2, SW10.S1
unnamed: SW11.1, U2.25 (33_MCLK2)
R1: J5.4, SW1.1, U2.24 (32_OUT1B)
R2: J5.3, SW2.1, U2.23 (31_CTX3)
R3: J5.2, SW3.1, U2.22 (30_CRX3)
R4: J5.1, SW4.1, U2.21 (29_TX7)
R5: SW5.1, SW6.1, SW7.1, SW8.1, SW9.1, U2.20 (28_RX7)
Reset: R25.2, U2.18 (26_A12_MOSI1)
RotA: C3.2, R3.1, U2.43 (21_A7_RX5_BCLK1)
RotB: C2.2, R4.2, U2.44 (22_A8_CTX1)
RotBTN: C4.1, R7.1, U2.45 (23_A9_CRX1_MCLK1)
Rx1: J1.4, U2.2 (0_RX1_CRX2_CS1)
Rx2: J2.4, U2.9 (7_RX2_OUT1A)
SCK: R22.2, U2.35 (13_SCK_LED)
SDI: R23.2, U2.13 (11_MOSI_CTX1)
SDO: R21.2, U2.14 (12_MISO_MQSL)
T_CLK: J4.5, JP2.1 (A)
T_CS: J4.4, U2.40 (18_A4_SDA)
T_DIN: J4.3, JP3.1 (A)
T_IRQ: J4.1, R10.1, U2.42 (20_A6_TX5_LRCLK1)
T_OUT: J4.2, JP1.1 (A)
Tx1: J1.6, U2.3 (1_TX1_CTX2_MISO1)
Tx2: J2.6, U2.10 (8_TX2_IN1)

Notes on the sheet:
Touch
LED

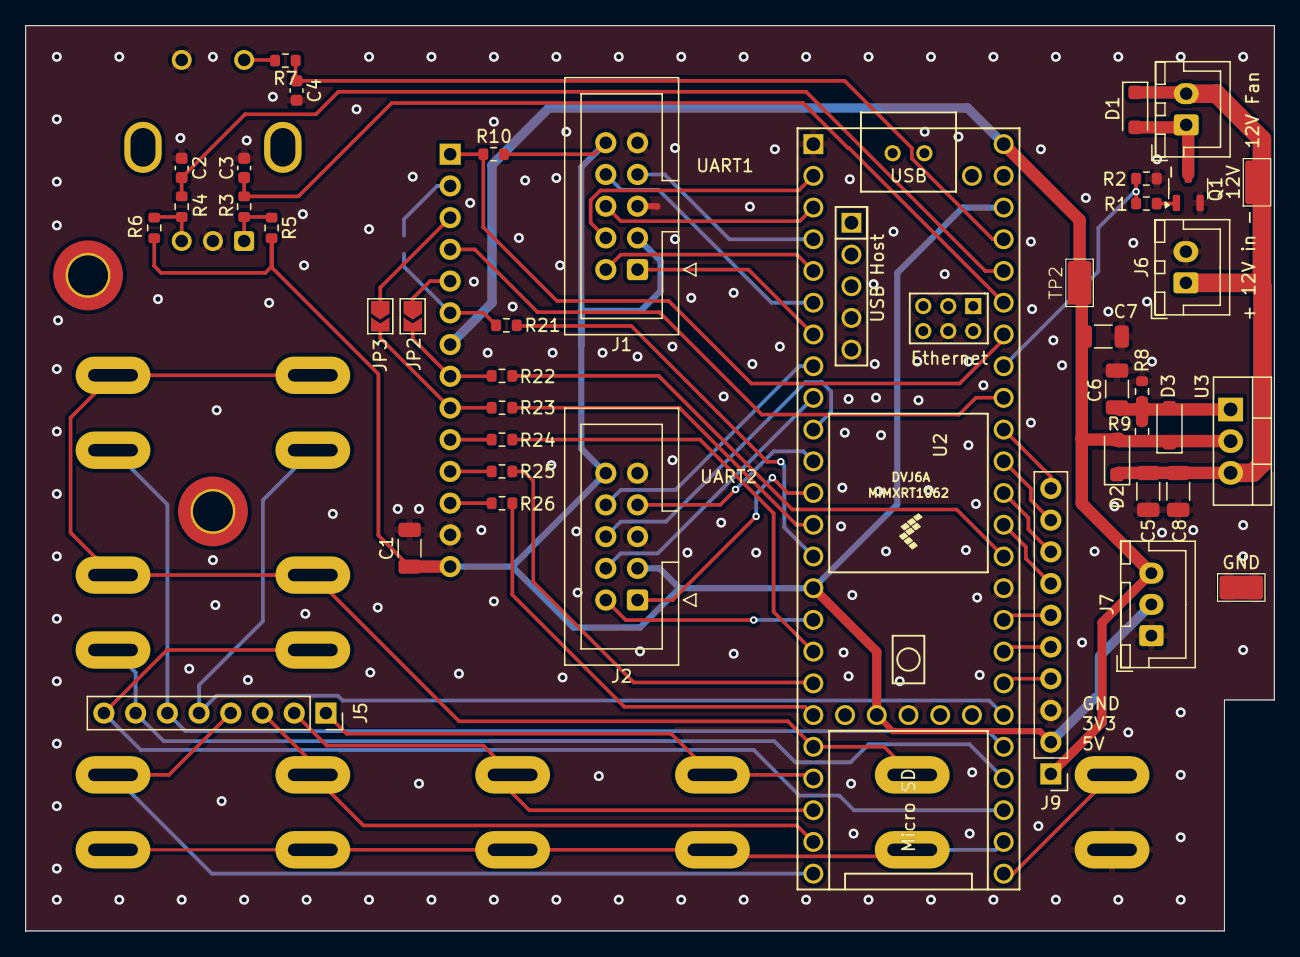
[picture p13: board PreciPSLoadFront.kicad_pcb from above]

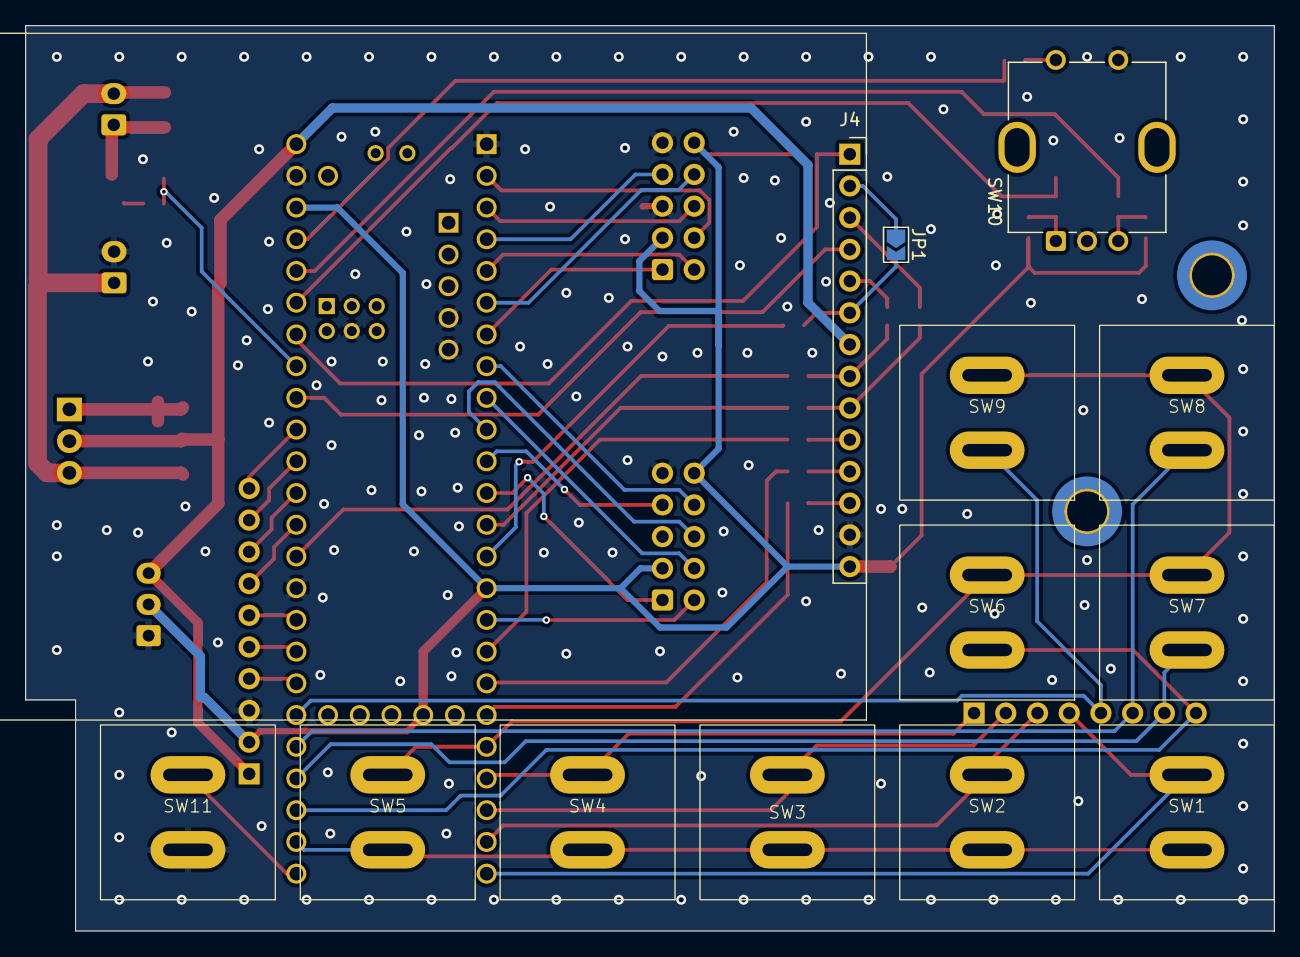
[picture p14: board PreciPSLoadFront.kicad_pcb from below]

Board: 2 copper layers, 100.0 x 72.5 mm, 55 parts (13 on the bottom side), 61 nets.
