janni0609/PsLoad/PSLoadModulio/src/main.cpp

#include <Arduino.h>

//++++++++++++++++++++++++++++++++++++++++++++++++++++++++++++++++++++++++++++++++++++++++++++++++++++
// func. proto.

void CheckSerialRx();
void Zero(double * array, int size);
void ValidateCal(double * array, int size);
void SendArray(char prefix, double array[]);
void SendDebug(uint32_t data);
void ReadData();
void TimerHandler1();
void ReadTemps();
void SendData();
void ReadADCs();
double Linear(double xValues[], double yValues[], int numValues, double pointX, bool trim);
void SendDebug(float data);


//++++++++++++++++++++++++++++++++++++++++++++++++++++++++++++++++++++++++++++++++++++++++++++++++++++
//DAC
#include <SPI.h>
#include <DAC7565.h>
DAC dac(PIN_PA5, PIN_PA7, PIN_PA4, PIN_PA1, PIN_PA3);

//++++++++++++++++++++++++++++++++++++++++++++++++++++++++++++++++++++++++++++++++++++++++++++++++++++
//ADC

#include <SparkFun_ADS1219.h>
SfeADS1219ArdI2C myADC;
const uint8_t ADCReset = PIN_PC5;
//const uint8_t interruptPin = PIN_PC4;

//++++++++++++++++++++++++++++++++++++++++++++++++++++++++++++++++++++++++++++++++++++++++++++++++++++
//Timer Interrupt

#define USING_FULL_CLOCK      true

// Try to use RTC, TCA0 or TCD0 for millis()
#define USE_TIMER_0           true          // Check if used by millis(), Servo or tone()
#define USE_TIMER_1           false         // Check if used by millis(), Servo or tone()

#if USE_TIMER_0
  #define CurrentTimer   ITimer0
#elif USE_TIMER_1
  #define CurrentTimer   ITimer1
#else
  #error You must select one Timer  
#endif


#include "ATtiny_TimerInterrupt.h"

//#define TIMER1_INTERVAL_MS        25L

volatile bool prozessStuff = 0;


//++++++++++++++++++++++++++++++++++++++++++++++++++++++++++++++++++++++++++++++++++++++++++++++++++++
const uint8_t SenseSW = PIN_PC3;
const uint8_t ON = PIN_PC0;
const uint8_t OnPhoto = PIN_PC1;

const uint8_t DataOut1 = PIN_PB4;       //Send Data
const uint8_t DataOut2 = PIN_PB5;       //Error flag

const uint8_t DataIn1 = PIN_PB6;
const uint8_t DataIn2 = PIN_PB7;

//++++++++++++++++++++++++++++++++++++++++++++++++++++++++++++++++++++++++++++++++++++++++++++++++++++
//Interpollation Cal
//#include "InterpolationLib.h"

double VoltSetPoints[10] =  {0.03f,  0.05f, 0.1f,  1.0f, 5.0f, 10.0f, 15.0f, 20.0f, 24.0f, 25.0f};
double VoltDacOffsets[10];
double VoltAdcOffsets[10];


double AmpSetPoints[] =     {0.0,     0.005,     0.05,    0.1,    0.5,    1.0,    4.0,    4.5,    4.9,     5.0};
double AmpDacPOffsets[10];
double AmpDacNOffsets[10];

double AmpAdcSetPoints[] =     {-5.0,     -4.9,     -4.5,    -4.0,    -1.0,    -0.5,    -0.1,    -0.05,    -0.005,     -0.0000001,     0.0,     0.005,     0.05,    0.1,    0.5,    1.0,    4.0,    4.5,    4.9,     5.0};
double AmpAdcOffsets[20];

// The fixed EEPROM offsets below (0/40/80/120/160) assume each cal table is a
// 10-element double array of 40 bytes, i.e. 4-byte doubles (true on avr-gcc).
static_assert(sizeof(double) == 4, "EEPROM cal layout assumes 4-byte double");

//++++++++++++++++++++++++++++++++++++++++++++++++++++++++++++++++++++++++++++++++++++++++++++++++++++
//Temp
const uint8_t Temper1 = PIN_PC2;
const uint8_t Temper2 = PIN_PA2;

const uint8_t OTP = 60;           // Over temp Protection
bool OTP_flag = 0;

//++++++++++++++++++++++++++++++++++++++++++++++++++++++++++++++++++++++++++++++++++++++++++++++++++++
//Globals for Sending
  float Volts, Amps, Temp1, Temp2;
  volatile bool ReadSerial = 0;

  bool OpMode = 0;      // 0 : Normal Power Supply Mode ; 1 : Capcity Meas Mode

  float AmpH, WattH;

  uint32_t Time = 0;
  uint32_t oldTime = 0;
  
  uint32_t myTime;

//++++++++++++++++++++++++++++++++++++++++++++++++++++++++++++++++++++++++++++++++++++++++++++++++++++
//Eeprom

#include <EEPROM.h>


void setup()
{
  //++++++++++++++++++++++++++++++++++++++++++++++++++++++++++++++++++++++++++++++++++++++++++++++++++++
  //Timer Interrupt

  CurrentTimer.init();
  
  CurrentTimer.attachInterruptInterval(25L , TimerHandler1);
  
  //++++++++++++++++++++++++++++++++++++++++++++++++++++++++++++++++++++++++++++++++++++++++++++++++++++
  //Temp
  pinMode(Temper1, INPUT);
  pinMode(Temper2, INPUT);
  analogReadResolution(12);
  analogReference(INTERNAL2V048);

  //++++++++++++++++++++++++++++++++++++++++++++++++++++++++++++++++++++++++++++++++++++++++++++++++++++
  //Serial
  Serial.begin(2000000);                //th. max Bd 2500000

  //++++++++++++++++++++++++++++++++++++++++++++++++++++++++++++++++++++++++++++++++++++++++++++++++++++
  // Initialize the DAC
  pinMode(PIN_PA6, OUTPUT);
  digitalWrite(PIN_PA6, LOW);
  delay(100);

  dac.init();
  delay(100);

  // Set DAC reference to be powered up, VREF = 2.5V
  // this mean that vout will be able to go from 0V to 2.5V (full scale)
  dac.setReference(DAC_REFERENCE_ALWAYS_POWERED_UP);
  delay(10);

  // Set all outputs to 0
  dac.writeChannel(DAC_CHANNEL_ALL, 0);

  //++++++++++++++++++++++++++++++++++++++++++++++++++++++++++++++++++++++++++++++++++++++++++++++++++++
  //ADC
  pinMode(ADCReset, OUTPUT);
  digitalWrite(ADCReset, HIGH);

  pinMode(PIN_PC4, INPUT);

  Wire.begin();
  Wire.setClock(1000000);
  delay(1);
  

  uint32_t adcBeginStart = millis();
  while (myADC.begin() == false)
  {
    if (millis() - adcBeginStart > 2000) break;   // don't hang setup if the ADC is absent
  }
  delay(1);
  myADC.setVoltageReference(ADS1219_VREF_EXTERNAL);
  myADC.setDataRate(ADS1219_DATA_RATE_330SPS);
  myADC.setConversionMode(ADS1219_CONVERSION_SINGLE_SHOT);
  
  //++++++++++++++++++++++++++++++++++++++++++++++++++++++++++++++++++++++++++++++++++++++++++++++++++++
  pinMode(SenseSW, OUTPUT);
  digitalWrite(SenseSW, LOW);

  pinMode(ON, OUTPUT);
  digitalWrite(ON, LOW);

  pinMode(OnPhoto, OUTPUT);
  digitalWrite(OnPhoto, LOW);

  pinMode(DataIn2, INPUT);
  pinMode(DataIn1, INPUT);
  attachInterrupt(digitalPinToInterrupt(DataIn1),  ReadData, FALLING);

  pinMode(DataOut1, OUTPUT);
  pinMode(DataOut2, OUTPUT);
  digitalWrite(DataOut1, HIGH);
  digitalWrite(DataOut2, LOW);
  

  //++++++++++++++++++++++++++++++++++++++++++++++++++++++++++++++++++++++++++++++++++++++++++++++++++++
  
  delay(1);

  EEPROM.get(0, VoltDacOffsets);
  EEPROM.get(40, VoltAdcOffsets);
  EEPROM.get(80, AmpDacPOffsets);
  EEPROM.get(120, AmpDacNOffsets);
  EEPROM.get(160, AmpAdcOffsets);

  // A fresh/erased EEPROM reads back as 0xFF -> NaN floats. Those would flow
  // through the cal math and produce undefined DAC output, so fall back to
  // zero offsets for any table that isn't finite.
  ValidateCal(VoltDacOffsets, 10);
  ValidateCal(VoltAdcOffsets, 10);
  ValidateCal(AmpDacPOffsets, 10);
  ValidateCal(AmpDacNOffsets, 10);
  ValidateCal(AmpAdcOffsets, 20);
  //SetZero();
}

/*  Commands
  Commands Send to module:

  v   set Voltage         (float)
  i   set Current Source  (float)
  s   set Current Sink    (float)
  o   Output on
  f   Output off
  h   Sense internal
  u   Sense External
  r   set Votage Raw Data (uint16_t)
  X   set Volt Cal Coeff. to Zero
  x   set Curr Cal Coeff. to Zero
  L   Cal Coeff. VoltDac
  K   Cal Coeff. VoltAdc
  I   Cal Coeff. CurrDacPos
  O   Cal Coeff. CurrDacNeg
  P   Cal Coeff. CurrAdc


  Commands Send to Front:

  V   meas. Voltage       (float)
  A   meas. Current       (float)
  n   meas. temp 1        (float)
  m   meas. temp 2        (float)
  E   Error               (uint8_t)
      OverTemp        Set     1
      OverTemp        Reset   0

*/

void loop()
{
  if (ReadSerial == 1) CheckSerialRx();
  //CheckSerialRx();

  if (digitalRead(DataIn2) && prozessStuff == 1 && OpMode == 0){
    //myTime = millis();

    ReadADCs();                 //
    ReadTemps();                //
    SendData();                 //all takes 9 ms

    //myTime = millis() - myTime;
    //SendDebug(myTime);

    prozessStuff = 0;
  }


  else if (digitalRead(DataIn2) && prozessStuff == 1 && OpMode == 1){
    ReadADCs();
    ReadTemps();
    SendData();



    Time = millis();

    uint32_t deltaTime = Time - oldTime;

    //AmpH =+ Amps * deltaTime * (1.0/3600000.0);
    AmpH = AmpH + (Amps * deltaTime * (1.0/3600000.0));

    //WattH =+ Watts * deltaTime * (1.0/3600000.0);
    //SendDebug(deltaTime);
    SendDebug(AmpH);


    oldTime = Time;
    
    prozessStuff = 0;
  }
}


void CheckSerialRx(void)      // ~ 600us
{
  ReadSerial = 0;

  //myTime = micros();
  while (Serial.available() > 0) {
    float num = 0.0;
    char first = Serial.read();
    if (first == 'v') {
      num = Serial.parseFloat();
      num += float(Linear(VoltSetPoints, VoltDacOffsets, 10, double(num), false));                     // cal
      num = constrain(num, 0.0, 25.0);
      num = num * 2621.4;                               //input  0-25 output 0-65535
      dac.writeChannel(DAC_CHANNEL_A, uint16_t(num));
      //Serial.println(num);
    }
    else if (first == 'i') {
      num = Serial.parseFloat();
      num += float(Linear(AmpSetPoints, AmpDacPOffsets, 10, double(num), false));                     // cal
      num = constrain(num, 0.0, 5.0);
      num = num * 13107.0;                              //input  0-5 output 0-65535
      dac.writeChannel(DAC_CHANNEL_B, uint16_t(num));
      //Serial.println(num);
    }
    else if (first == 's') {
      num = Serial.parseFloat();
      num += float(Linear(AmpSetPoints, AmpDacNOffsets, 10, double(num), false));                     // cal
      num = constrain(num, 0.0, 5.0);
      num = num * 13107.0;                               //input  0-5 output 0-65535
      dac.writeChannel(DAC_CHANNEL_C, uint16_t(num));
      //Serial.println(num);
    }
    else if (first == 'o') {                                  //on
      digitalWrite(OnPhoto, HIGH);
      //delayMicroseconds(1200);                           //mos turn on delay
      digitalWrite(ON, HIGH);
      //Serial.println("output ON");
    }
    else if (first == 'f') {                                  //off
      digitalWrite(OnPhoto, LOW);
      //delayMicroseconds(300);                            //mos turn off delay
      digitalWrite(ON, LOW);
      //Serial.println("output OFF");
    }
    else if (first == 'h') {                                  //Sense internal
      digitalWrite(SenseSW, LOW);
      //Serial.println("Sense internal");
    }
    else if (first == 'u') {                                  //Sense external
      digitalWrite(SenseSW, HIGH);
      //Serial.println("Sense external");
    }
    else if (first == 'r') {                                  //Raw Data in
      uint16_t Raw = Serial.parseInt();
      
      dac.writeChannel(DAC_CHANNEL_A, Raw);
      //Serial.println(num);
    }
    else if (first == 'X') {
      //EEPROM.put(0, StorCalConst);
      Zero(VoltDacOffsets, 10);
      Zero(VoltAdcOffsets, 10);
    }
    else if (first == 'x') {
      //EEPROM.put(0, StorCalConst);
      Zero(AmpDacPOffsets, 10);
      Zero(AmpDacNOffsets, 10);
      Zero(AmpAdcOffsets, 20);
    }
    else if (first == 'Y') {
      SendArray('y', VoltDacOffsets);
    }
    else if (first == 'L'){
      uint8_t n = Serial.parseInt();
      float flt = Serial.parseFloat();
      VoltDacOffsets[n] = flt;
    }
    else if (first == 'K'){
      uint8_t n = Serial.parseInt();
      float flt = Serial.parseFloat();
      VoltAdcOffsets[n] = flt;
    }
    else if (first == 'I'){
      uint8_t n = Serial.parseInt();
      float flt = Serial.parseFloat();
      AmpDacPOffsets[n] = flt;
    }
    else if (first == 'O'){
      uint8_t n = Serial.parseInt();
      float flt = Serial.parseFloat();
      AmpDacNOffsets[n] = flt;
    }
    else if (first == 'P'){
      uint8_t n = Serial.parseInt();
      float flt = Serial.parseFloat();
      AmpAdcOffsets[n] = flt;
    }
    else if (first == 'S') {                                  //store Cal
      EEPROM.put(0, VoltDacOffsets);
      EEPROM.put(40, VoltAdcOffsets);
      EEPROM.put(80, AmpDacPOffsets);
      EEPROM.put(120, AmpDacNOffsets);
      EEPROM.put(160, AmpAdcOffsets);
    }
  }
  

  //myTime = micros() - myTime;
  //SendDebug(myTime);
}

void Zero(double * array, int size){
  for (uint8_t n = 0; n < size; n++){
    array[n] = 0.0;
  }
}

void ValidateCal(double * array, int size){
  for (int n = 0; n < size; n++){
    if (isnan(array[n]) || isinf(array[n])){   // erased EEPROM / corrupt table
      Zero(array, size);
      return;
    }
  }
}

void SendArray(char prefix, double array[]){
  
  //Serial.print(prefix);
  for (uint8_t n = 0; n <= 9; n++){
    digitalWrite(DataOut1,LOW);
    Serial.print(prefix);
    Serial.print(array[n], 7);
    digitalWrite(DataOut1,HIGH);
  }
  
}

void SendDebug(uint32_t data){
  digitalWrite(DataOut1,LOW);
  Serial.println("v");
  Serial.print(data);
  Serial.println("l");
  digitalWrite(DataOut1,HIGH);
}

void SendDebug(float data){
  digitalWrite(DataOut1,LOW);
  Serial.println("y");
  Serial.print(data,6);
  Serial.println("l");
  digitalWrite(DataOut1,HIGH);
}

void ReadADCs(void)
{

  myADC.setInputMultiplexer(ADS1219_CONFIG_MUX_DIFF_P0_N1);
  if (myADC.startSync()) // Start a single-shot conversion. This will return true on success.
  {
    uint32_t convStart = millis();
    while (myADC.dataReady() == false) // Check if the conversion is complete. This will return true if data is ready.
    {
      if (millis() - convStart > 50) break; // bail out instead of hanging if the ADC stalls
      //delay(1); // The conversion is not complete. Wait a little to avoid pounding the I2C bus.
    }


    myADC.readConversion(); // Read the conversion result from the ADC. Store it internally.
    float ADCreading = myADC.getConversionMillivolts(2500.0); // Convert to millivolts.
    ADCreading = 1250.0 - ADCreading;
    ADCreading = ADCreading * 4.0;
    Amps = ADCreading/1000.0;
    Amps += Linear(AmpAdcSetPoints, AmpAdcOffsets, 20, Amps, true);
    Amps = Amps - Volts / 110000.0;
    //Serial.print("mAmps: ");
    //Serial.print(ADCreading, 3);
  }

  myADC.setInputMultiplexer(ADS1219_CONFIG_MUX_DIFF_P2_N3);
  if (myADC.startSync()) // Start a single-shot conversion. This will return true on success.
  {
    uint32_t convStart = millis();
    while (myADC.dataReady() == false) // Check if the conversion is complete. This will return true if data is ready.
    {
      if (millis() - convStart > 50) break; // bail out instead of hanging if the ADC stalls
      //delay(1); // The conversion is not complete. Wait a little to avoid pounding the I2C bus.
    }

    myADC.readConversion(); // Read the conversion result from the ADC. Store it internally.
    float milliVolts = myADC.getConversionMillivolts(2500.0); // Convert to millivolts.
    Volts = milliVolts/100.0;
    Volts += Linear(VoltSetPoints, VoltAdcOffsets, 10, double(Volts), true);
    Volts = Volts;
    //Serial.print("   Volt: ");
    //Serial.print(milliVolts / 100.0, 6);
  } 
}

void SendData(void)
{
  digitalWrite(DataOut1,LOW);
  Serial.print("V");
  Serial.print(Volts,6);
  Serial.print("A");
  Serial.print(Amps,6);
  Serial.print("n");
  Serial.print(Temp1,1);
  Serial.print("m");
  Serial.print(Temp2,1);
  Serial.println("l");
  digitalWrite(DataOut1,HIGH);
}

void ReadTemps(void)
{
  float tempsensor = analogRead(Temper1);
  tempsensor = tempsensor * 0.0005;             //convert to volt
  tempsensor = tempsensor - 0.5;
  tempsensor = tempsensor/0.01;                 //convert to Celsius
  Temp1 = tempsensor;


  tempsensor = analogRead(Temper2);
  tempsensor = tempsensor * 0.0005;             //convert to volt
  tempsensor = tempsensor - 0.5;
  tempsensor = tempsensor/0.01;                 //convert to Celsius
  Temp2 = tempsensor;

  float maxTemp;

  if (Temp1 > Temp2) maxTemp = Temp1;
  else maxTemp = Temp2;

  if (maxTemp >= OTP && OTP_flag == 0){
    OTP_flag = 1;
    digitalWrite(OnPhoto, LOW);
    //delayMicroseconds(300);                         //mos turn off delay
    digitalWrite(ON, LOW);

    digitalWrite(DataOut2, HIGH);                     //Raise Error Flag
  }else if (maxTemp < OTP && OTP_flag == 1){
    OTP_flag = 0;
    digitalWrite(DataOut2, LOW);                      //Reset Error Flag
    
    //digitalWrite(OnPhoto, HIGH);
    //delayMicroseconds(1200);                        //mos turn on delay
    //digitalWrite(ON, HIGH);
  }

}

void TimerHandler1()    //ISR
{
  prozessStuff = 1;
}

void ReadData(void)     //ISR
{
  ReadSerial = 1;
}

double Linear(double xValues[], double yValues[], int numValues, double pointX, bool trim)
{
	if (trim)
	{
		if (pointX <= xValues[0]) return yValues[0];
		if (pointX >= xValues[numValues - 1]) return yValues[numValues - 1];
	}

	auto i = 0;
	double rst = 0;
	if (pointX <= xValues[0])
	{
		i = 0;
		auto t = (pointX - xValues[i]) / (xValues[i + 1] - xValues[i]);
		rst = yValues[i] * (1 - t) + yValues[i + 1] * t;
	}
	else if (pointX >= xValues[numValues - 1])
	{
		auto t = (pointX - xValues[numValues - 2]) / (xValues[numValues - 1] - xValues[numValues - 2]);
		rst = yValues[numValues - 2] * (1 - t) + yValues[numValues - 1] * t;
	}
	else
	{
		while (pointX >= xValues[i + 1]) i++;
		auto t = (pointX - xValues[i]) / (xValues[i + 1] - xValues[i]);
		rst = yValues[i] * (1 - t) + yValues[i + 1] * t;
	}

	return rst;

}
