janni0609/PsLoad/Software/FrontPanel/FrontMCUV7.ino

#include <movingAvgFloat.h>
#include "SPI.h"
#include "TFT_eSPI.h"

TFT_eSPI tft = TFT_eSPI();

float VoltCH1, AmpCH1, WattCH1, temp1, temp2;

int DataIn1 = 5;
int DataIn2 = 3;
int DataOut1 = 4;
int DataOut2 = 2;

uint8_t InterrSW = 33;

int Debug = 39;

int Fan = 19;

bool Error = 0;

bool DataReadyCh1 = 0;
bool DispData = 0;

movingAvgFloat avgVoltCH1(10);
movingAvgFloat avgAmpCH1(10);

movingAvgFloat avgVoltCalCH1(50);
movingAvgFloat avgAmpCH1Cal(50);

//------------------------------------------------------------------------------------------------
//Encoder
const uint8_t RotClk = 21;
const uint8_t RotDt = 22;

const uint8_t RotBtn = 13;

int counter = 0;

bool last_run = LOW;
bool aState;
bool lastaState;

bool sendData = 0;

bool sendVolt = 0;
bool sendCurrP = 0;
bool sendCurrN = 0;

//------------------------------------------------------------------------------------------------
//SetPoints CH1
float VsetCH1 = 5.0;
float IpsetCH1 = 1.0;
float InsetCH1 = 1.0;

bool PwSetCH1 = 0;
bool PwSetCH2 = 0;

int8_t factor = 0;
uint8_t SetType = 0;            // 0: Vset, 1: Ipset, 2:Inset
bool ChannelSet = 0;            // 0: CH1, 1: CH2

//bool upDateUndLine = 1;
volatile uint8_t mode = 0;               // 0: normla PSLoad Mode,

bool CalVal = 0;

//------------------------------------------------------------------------------------------------
//Metro
#include <Metro.h>                      //Include Metro library

Metro FanMetro = Metro(250);            // Instanciate a metro object and set the interval to 250 milliseconds (0.25 seconds).

//Metro IoT = Metro(1000);            // Instanciate a metro object and set the interval to 250 milliseconds (0.25 seconds).

//++++++++++++++++++++++++++++++++++++++++++++++++++++++++++++++++++++++++++++++++++++++++++++++++++++
//Cal

double VoltSetPoints[] =     {0.03,   0.05,     0.1,    1.0,    5.0,    10.0,   15.0,   20.0,   24.0,   25.0};
double VoltDacOffsets[] =    {0.0,    0.0,      0.0,    0.0,    0.0,    0.0,    0.0,    0.0,    0.0,    0.0};
double VoltAdcOffsets[] =    {0.0,    0.0,      0.0,    0.0,    0.0,    0.0,    0.0,    0.0,    0.0,    0.0};


//double AmpAdcPOffsets[10];
//double AmpAdcNOffsets[10];

double AmpAdcSetPoints[] =     {-5.0,     -4.9,     -4.5,    -4.0,    -1.0,    -0.5,    -0.1,    -0.05,    -0.005,     0.0,     0.0,     0.005,     0.05,    0.1,    0.5,    1.0,    4.0,    4.5,    4.9,     5.0};
double AmpAdcOffsets[20];

double AmpSetPoints[] =     {0.0,     0.005,     0.05,    0.1,    0.5,    1.0,    4.0,    4.5,    4.9,     5.0};
double AmpDacPOffsets[] =   {0.0,     0.0,      0.0,    0.0,    0.0,    0.0,    0.0,    0.0,    0.0,    0.0};
double AmpDacNOffsets[] =   {0.0,     0.0,      0.0,    0.0,    0.0,    0.0,    0.0,    0.0,    0.0,    0.0};


//------------------------------------------------------------------------------------------------
//SetPoints CH1
#include <Keypad.h>

const byte ROWS = 5; //four rows
const byte COLS = 5; //three columns
char keys[ROWS][COLS] = {
  {'1','2','3','A','I'},
  {'4','5','6','B','J'},
  {'7','8','9','C','K'},
  {'.','0','#','D','L'},
  {'E','F','G','H','M'}
};
byte rowPins[ROWS] = {32, 31, 30, 29, 28}; //connect to the row pinouts of the keypad
byte colPins[COLS] = {35, 36, 37, 38, 34}; //connect to the column pinouts of the keypad

Keypad keypad = Keypad( makeKeymap(keys), rowPins, colPins, ROWS, COLS );

void setup() 
{

  //Encoder
  pinMode(RotClk, INPUT);
  pinMode(RotDt, INPUT);
  pinMode(RotBtn, INPUT_PULLUP);
  attachInterrupt(digitalPinToInterrupt(RotBtn),  RotBtnISR, FALLING);
  attachInterrupt(digitalPinToInterrupt(RotClk),  shaft_moved, CHANGE);
  //------------------------------------------------------------------------------------------------

  Serial1.begin(1000000);

  Serial.begin(1000000);

  analogWriteFrequency(Fan, 25000);

  pinMode(Debug, OUTPUT);
  pinMode(DataOut1, OUTPUT);
  pinMode(DataOut2, OUTPUT);

  pinMode(InterrSW, INPUT_PULLUP);
  attachInterrupt(digitalPinToInterrupt(InterrSW),  ModeSwISR, FALLING);

  digitalWrite(DataOut1, LOW);
  digitalWrite(DataOut2, LOW);

  pinMode(DataIn2, INPUT);

  pinMode(DataIn1, INPUT);
  attachInterrupt(DataIn1, DataReadyCH1, RISING);

  avgVoltCH1.begin();
  avgAmpCH1.begin();

  avgVoltCalCH1.begin();
  avgAmpCH1Cal.begin();

  tft.begin();
  tft.setRotation(1);

  tft.fillScreen(TFT_BLACK);


  //EEPROM.get(0, VoltDacOffsets);
  //EEPROM.get(80, VoltAdcOffsets);

  //EEPROM.get(160, AmpAdcOffsets);
  //EEPROM.get(320, AmpDacNOffsets);
  //EEPROM.get(400, AmpDacPOffsets);

  /*

  for (uint8_t n  = 0; n <= 9; n++){
    digitalWrite(DataOut1, HIGH);
    Serial1.print('L');
    Serial1.print(n);
    Serial1.print(' ');
    Serial1.print(0.0);
    digitalWrite(DataOut1, LOW);
  }

  */
  

  


  //Serial.println(sizeof(VoltDacOffsets));
 
  //initPSLoad();
}

/*
Commands Send to module:

v   set Voltage         (float)
i   set Current Source  (float)
s   set Current Sink    (float)
o   Output on
f   Output off
h   Sense internal
u   Sense External
r   set Votage Raw Data (uint16_t)
X   set Volt Cal Coeff. to Zero
x   set Curr Cal Coeff. to Zero
L   Cal Coeff. VoltDac
K   Cal Coeff. VoltAdc
I   Cal Coeff. CurrDacPos
O   Cal Coeff. CurrDacNeg
P   Cal Coeff. CurrAdc


Commands Send to Front:

V   meas. Voltage       (float)
A   meas. Current       (float)
n   meas. temp 1        (float)
m   meas. temp 2        (float)


*/

void initPSLoad(){
  
  tft.fillRect(0, 0, 320, 240, TFT_BLACK);

  tft.fillRect(159, 0, 2, 240, TFT_RED);

  tft.setTextPadding(0);
  tft.setTextDatum(TL_DATUM);
  tft.drawString("C", 35, 0, 2);
  tft.drawString("C", 95, 0, 2);

  //tft.setTextPadding(100);
  tft.setTextColor(TFT_ORANGE, TFT_BLACK);
  tft.drawChar('V', 135, 30, 4);
  tft.setTextColor(TFT_YELLOW, TFT_BLACK);
  tft.drawChar('A', 135, 60, 4);
  tft.setTextColor(TFT_SKYBLUE, TFT_BLACK);
  tft.drawChar('W', 135, 90, 4);

  tft.setTextColor(TFT_ORANGE, TFT_BLACK);
  tft.drawChar('V', 135, 150, 4);
  tft.setTextColor(TFT_YELLOW, TFT_BLACK);
  tft.drawChar('A', 135, 180, 4);
  tft.setTextColor(TFT_YELLOW, TFT_BLACK);
  tft.drawChar('A', 135, 210, 4);

  tft.setTextColor(TFT_WHITE, TFT_BLACK);

  tft.drawString("Set", 0, 120, 4);
  tft.setTextColor(TFT_ORANGE, TFT_BLACK);
  tft.drawString("V", 0, 150, 4);
  tft.setTextColor(TFT_YELLOW, TFT_BLACK);
  tft.drawString("I+", 0, 180, 4);
  tft.setTextColor(TFT_YELLOW, TFT_BLACK);
  tft.drawString("I-", 0, 210, 4);
  tft.setTextColor(TFT_WHITE, TFT_BLACK);


  digitalWrite(DataOut1, HIGH);
  if(PwSetCH1) Serial1.print("o");
  if(!PwSetCH1) Serial1.print("f");
  digitalWrite(DataOut1, LOW);

  tft.setTextPadding(100);

  SendDataToCh1('v', VsetCH1);
  SendDataToCh1('i', IpsetCH1);
  SendDataToCh1('s', InsetCH1);

  dispSetData();

  Serial.println("Start");
  digitalWrite(DataOut2, HIGH);
}

void LoopPSload(){

  Serial.println("enter PSLoad Func");

  initPSLoad();

  while (mode == 0){                  //PSLoad normal mode
    if (DataReadyCh1)   GetDataCH1();
    if (DispData)       dipsData();


    if (sendVolt) {
      dispSetData();
      SendDataToCh1('v', VsetCH1);
      sendVolt = 0;
    }
    if (sendCurrP) {
      dispSetData();
      SendDataToCh1('i', IpsetCH1);
      sendCurrP = 0;
    }
    if (sendCurrN) {
      SendDataToCh1('s', InsetCH1);
      dispSetData();
      sendCurrN = 0;
    }

    float keyreturn = checkKeys();
    if (keyreturn != -1.0) Serial.println(keyreturn, 4);
    processNumPad(keyreturn);


    if (FanMetro.check())  FanContr();

  /*
    if (IoT.check()){
      Serial.print("Volt: ");
      Serial.print(VoltCH1,5);
      Serial.print("  Amp: ");
      Serial.print(AmpCH1,5);
      Serial.print("  Temp: ");
      Serial.println(temp1,1);
    }
  */

    
    while (Serial.available() > 0){
      //Serial.println("Start");
      char firstChar = Serial.read();
      if (firstChar == 'H'){
        for (uint8_t n = 0; n <= 3; n++){
          Serial.println(Serial.parseFloat());
        }
        Serial.println("Finish");
      }
      if (firstChar == 'L'){
        uint8_t n = Serial.parseInt();
        float flt = Serial.parseFloat();
        Serial.print(n);
        Serial.print(' ');
        Serial.println(flt,6);
      }
    }
  }       //while loop
}         //function


void CalMode(){
  tft.fillRect(0, 0, 320, 240, TFT_BLACK);

  tft.setTextDatum(TL_DATUM);
  tft.setTextPadding(200);
  tft.setTextColor(TFT_ORANGE, TFT_BLACK);
  tft.drawString("A: Calibrate Voltage", 0, 0, 4);
  tft.drawString("B: Calibrate Current", 0, 30, 4);
  tft.drawString("D: Exit", 0, 60, 4);

  uint8_t n = 0;

  while(mode == 1){
    char key = keypad.getKey();

    if (key == 'D'){
      mode = 0;
    }
    else if (key == 'A'){            //Enter Volt Cal Mode
      CalVoltage();
      mode = 0;
    }
    else if (key == 'B'){             //Enter Curr Cal Mode
      CalCurrent();
      mode = 0;
    }
  }

  //EEPROM.put(160, AmpAdcOffsets);
  //EEPROM.put(320, AmpDacNOffsets);
  //EEPROM.put(400, AmpDacPOffsets);

  //if (FanMetro.check())  FanContr();
  Serial.println("finish");
  //mode = 0;

}

void CalCurrent(){

  float CalAmp;

  double AmpAdcSetPoints[] =     {-5.0,     -4.9,     -4.5,    -4.0,    -1.0,    -0.5,    -0.1,    -0.05,    -0.005,     0.0,     0.0,     0.005,     0.05,    0.1,    0.5,    1.0,    4.0,    4.5,    4.9,     5.0};
  double AmpAdcOffsets[20];

  double AmpSetPoints[] =     {0.0,     0.005,     0.05,    0.1,    0.5,    1.0,    4.0,    4.5,    4.9,     5.0};
  double AmpDacPOffsets[10];
  double AmpDacNOffsets[10];


  Serial.println("enter Cal Func");

  digitalWrite(DataOut2, HIGH);

  digitalWrite(DataOut1, HIGH);
  Serial1.print("o");
  digitalWrite(DataOut1, LOW);
  

  tft.fillRect(0, 0, 320, 240, TFT_BLACK);

  digitalWrite(DataOut1, HIGH);
  Serial1.print('x');
  digitalWrite(DataOut1, LOW);


  analogWrite(Fan, 255);

  uint8_t n = 0;
  while (n <= 9){                   //Cal Amp Source
    tft.fillRect(0, 0, 320, 240, TFT_BLACK);
    tft.setTextDatum(TL_DATUM);
    tft.setTextPadding(200);
    tft.setTextColor(TFT_ORANGE, TFT_BLACK);
    tft.drawString("Meas A Surc. Ch1:", 0, 10, 4);
    tft.drawString("WAIT!", 0, 40, 4);
    tft.drawFloat(AmpSetPoints[n], 3, 240, 10, 4);
    SendDataToCh1('i', AmpSetPoints[n]);
    //Serial.println("Cal V1");

    uint8_t AvgCounter = 0;

    uint8_t Check_n = n;

    while(Check_n == n){
      //Serial.println("DataReadyCh1: ");
      //Serial.println(DataReadyCh1);
      if (DataReadyCh1)   GetDataCH1();
      if (DispData){
        CalAmp = avgAmpCH1Cal.reading(AmpCH1);
        DispData = 0;
        AvgCounter++;
      }
      if(AvgCounter >= 50){
        if (AvgCounter == 50){
          tft.setTextDatum(TL_DATUM);
          tft.setTextPadding(200);
          tft.setTextColor(TFT_ORANGE, TFT_BLACK);
          tft.drawString("Enter Value", 0, 40, 4);
        }
        AvgCounter = 200;
        

        double keyreturn = checkKeys();
        if (keyreturn != -1.0){
          AmpDacPOffsets[n] = AmpSetPoints[n] - keyreturn;
          AmpAdcOffsets[9-n] = (keyreturn - CalAmp);

          Serial.print("Offset DAC: ");
          Serial.print(AmpDacPOffsets[n],6);
          Serial.print("  Offset ADC: ");
          Serial.println(AmpAdcOffsets[9-n],6);

          n++;
        }
      }
    }
  }

  SendDataToCh1('i', 0.0);
  SendDataToCh1('v', 0.1);

  n = 0;
  while (n <= 9){                   //Cal Amp Sink
    tft.fillRect(0, 0, 320, 240, TFT_BLACK);
    tft.setTextDatum(TL_DATUM);
    tft.setTextPadding(200);
    tft.setTextColor(TFT_ORANGE, TFT_BLACK);
    tft.drawString("Meas A Sink Ch1:", 0, 10, 4);
    tft.drawString("WAIT!", 0, 40, 4);
    tft.drawFloat(AmpSetPoints[n], 3, 240, 10, 4);
    SendDataToCh1('s', AmpSetPoints[n]);
    //Serial.println("Cal V1");

    uint8_t AvgCounter = 0;

    uint8_t Check_n = n;

    while(Check_n == n){
      //Serial.println("DataReadyCh1: ");
      //Serial.println(DataReadyCh1);
      if (DataReadyCh1)   GetDataCH1();
      if (DispData){
        CalAmp = avgAmpCH1Cal.reading(AmpCH1);
        DispData = 0;
        AvgCounter++;
      }
      if(AvgCounter >= 50){
        if (AvgCounter == 50){
          tft.setTextDatum(TL_DATUM);
          tft.setTextPadding(200);
          tft.setTextColor(TFT_ORANGE, TFT_BLACK);
          tft.drawString("Enter Value", 0, 40, 4);
        }
        AvgCounter = 200;
        

        double keyreturn = checkKeys();
        if (keyreturn != -1.0){
          AmpDacNOffsets[n] = -(AmpSetPoints[n] - keyreturn);
          AmpAdcOffsets[n+10] = keyreturn + CalAmp;

          Serial.print("Offset DAC: ");
          Serial.print(AmpDacNOffsets[n],6);
          Serial.print("  Offset ADC: ");
          Serial.println(AmpAdcOffsets[n+10],6);

          n++;
        }
      }
    }
  }

  //I   Cal Coeff. CurrDacPos
  //O   Cal Coeff. CurrDacNeg
  //P   Cal Coeff. CurrAdc

  SendArray('I', AmpDacPOffsets, 10);
  SendArray('O', AmpDacNOffsets, 10);
  SendArray('K', AmpAdcOffsets, 20);


  digitalWrite(DataOut1, HIGH);           //Store Cal Cost. in Module EEprom
  Serial1.print('S');
  digitalWrite(DataOut1, LOW);

  SendDataToCh1('i', 0.1);
  SendDataToCh1('s', 0.1);
  
}

void CalVoltage(){
  float CalVolt;

  double VoltSetPoints[] =     {0.03,   0.05,     0.1,    1.0,    5.0,    10.0,   15.0,   20.0,   24.0,   25.0};
  double VoltDacOffsets[10];
  double VoltAdcOffsets[10];

  Serial.println("enter Cal Func");

  digitalWrite(DataOut2, HIGH);

  digitalWrite(DataOut1, HIGH);
  Serial1.print("o");
  digitalWrite(DataOut1, LOW);
  

  tft.fillRect(0, 0, 320, 240, TFT_BLACK);

  digitalWrite(DataOut1, HIGH);
  Serial1.print('X');
  digitalWrite(DataOut1, LOW);
  uint8_t n = 0;

  while (n <= 9){
    tft.fillRect(0, 0, 320, 240, TFT_BLACK);
    tft.setTextDatum(TL_DATUM);
    tft.setTextPadding(200);
    tft.setTextColor(TFT_ORANGE, TFT_BLACK);
    tft.drawString("Meas Volt Ch1:", 0, 10, 4);
    tft.drawString("WAIT!", 0, 40, 4);
    tft.drawFloat(VoltSetPoints[n], 3, 180, 10, 4);
    SendDataToCh1('v', VoltSetPoints[n]);
    //Serial.println("Cal V1");

    uint8_t AvgCounter = 0;

    uint8_t Check_n = n;

    while(Check_n == n){
      //Serial.println("DataReadyCh1: ");
      //Serial.println(DataReadyCh1);
      if (DataReadyCh1)   GetDataCH1();
      if (DispData){
        CalVolt = avgVoltCalCH1.reading(VoltCH1);
        DispData = 0;
        AvgCounter++;
      }
      if(AvgCounter >= 60){
        if (AvgCounter == 60){
          tft.setTextDatum(TL_DATUM);
          tft.setTextPadding(200);
          tft.setTextColor(TFT_ORANGE, TFT_BLACK);
          tft.drawString("Enter Value", 0, 40, 4);
        }
        AvgCounter = 200;
        

        double keyreturn = checkKeys();
        if (keyreturn != -1.0){
          VoltDacOffsets[n] = VoltSetPoints[n] - keyreturn;
          VoltAdcOffsets[n] = keyreturn - CalVolt;

          Serial.print("Offset DAC: ");
          Serial.print(VoltDacOffsets[n],6);
          Serial.print("  Offset ADC: ");
          Serial.println(VoltAdcOffsets[n],6);

          n++;
        }
      }
    }
  }
  SendArray('L', VoltDacOffsets, 10);
  SendArray('K', VoltAdcOffsets, 10);

  digitalWrite(DataOut1, HIGH);           //Store Cal Cost. in Module EEprom
  Serial1.print('S');
  digitalWrite(DataOut1, LOW);

  Serial.println("finish Volt Cal");
}

void SendArray(char prefix, double array[], uint16_t size){
  
  //Serial1.print(prefix);
  for (uint8_t n = 0; n < size; n++){
    digitalWrite(DataOut1, HIGH);
    Serial1.print(prefix);
    Serial1.print(n);
    Serial1.print(' ');
    Serial1.print(array[n], 6);
    digitalWrite(DataOut1, LOW);
    delay(30);
  }
  
}

void ModeSwISR(){
  //mode = !mode;
  mode = 1;
}

void SendDataToCh1(char prefix, float data){


  digitalWrite(DataOut1, HIGH);
  Serial1.print(prefix);
  Serial1.print(data, 6);
  Serial1.print('t');
  digitalWrite(DataOut1, LOW);
}

void RotBtnISR(){   //ISR
  //sendData = 1;
}

float factorSelV(void){
  if (factor == 0) return 0.001;
  if (factor == 1) return 0.01;
  if (factor == 2) return 0.1;
  if (factor == 3) return 1.0;
  if (factor == 4) return 10.0;
}

float factorSelI(void){
  if (factor == 0) return 0.0001;
  if (factor == 1) return 0.001;
  if (factor == 2) return 0.01;
  if (factor == 3) return 0.1;
  if (factor == 4) return 1.0;
}

void shaft_moved(){   //ISR
  aState = digitalRead(RotClk);
  
  last_run = !last_run;
  if(last_run == LOW){
    if (digitalRead(RotDt) != aState)
    {
      counter++;
      if(ChannelSet == 0){                      //Set Ch1
        if (SetType == 0){                      //Set Volts
          VsetCH1 = VsetCH1 +  factorSelV();
          sendVolt = 1;
        }else if(SetType == 1){                 //Set I +
          IpsetCH1 = IpsetCH1 + factorSelI();
          sendCurrP = 1;
        }else if(SetType == 2){                 //Set I +
          InsetCH1 = InsetCH1 + factorSelI();
          sendCurrN = 1;
        }
      }
      if(ChannelSet == 1){                      //Set Ch2

      }


    }else{
      counter--;
      if(ChannelSet == 0){                      //Set Ch1
        if (SetType == 0){                      //Set Volts
          VsetCH1 = VsetCH1 -  factorSelV();
          sendVolt = 1;
        }else if(SetType == 1){                 //Set I +
          IpsetCH1 = IpsetCH1 - factorSelI();
          sendCurrP = 1;
        }else if(SetType == 2){                 //Set I +
          InsetCH1 = InsetCH1 - factorSelI();
          sendCurrN = 1;
        }
      }
      if(ChannelSet == 1){                      //Set Ch2

      }
    }
    VsetCH1 = constrain(VsetCH1, 0.02, 25.0);
    IpsetCH1 = constrain(IpsetCH1, 0.000001, 5.0);
    InsetCH1 = constrain(InsetCH1, 0.000001, 5.0);
  }
}

void DataReadyCH1(void){  //ISR
  DataReadyCh1 = 1;
}

void GetDataCH1(void){
  while (Serial1.available() > 0){
    //Serial.println("Get Data");
    char first = Serial1.read();
    if (first == 'V'){
      VoltCH1 = Serial1.parseFloat();
    }
    if (first == 'A'){
      AmpCH1 = Serial1.parseFloat();
    }
    if (first == 'n'){
      temp1 = Serial1.parseFloat();
    }
    if (first == 'm'){
      temp2 = Serial1.parseFloat();
    }
    if (first == 'y'){
      //for (uint8_t n = 0; n <= 9; n++){
        Serial.println(Serial1.parseFloat(), 6);
      //}
      //Serial.println('#');
    }
    if (first == 'v'){
      Serial.println(Serial1.parseFloat(),9);
      Serial.println('#');
    }else{

    }
  }
  DataReadyCh1 = 0;
  DispData = 1;
}

void dipsData(){
  //digitalWrite(Debug, HIGH);
  VoltCH1 = avgVoltCH1.reading(VoltCH1);          //mooving Average
  AmpCH1 = avgAmpCH1.reading(AmpCH1);             //mooving Average

  tft.setTextDatum(TR_DATUM);
  tft.setTextColor(TFT_ORANGE, TFT_BLACK);

  tft.setTextPadding(135);
  tft.drawFloat(VoltCH1, 5, 125, 30, 4);

  tft.setTextColor(TFT_YELLOW, TFT_BLACK);
  tft.drawFloat(AmpCH1, 5, 125, 60, 4);

  WattCH1 = VoltCH1 * AmpCH1;
  tft.setTextColor(TFT_SKYBLUE, TFT_BLACK);
  tft.drawFloat(WattCH1, 5, 125, 90, 4);

  //digitalWrite(Debug, LOW);
  DispData = 0;
}

void dispSetData(){
  tft.setTextDatum(TR_DATUM);
  tft.setTextPadding(100);
  tft.setTextColor(TFT_ORANGE, TFT_BLACK);
  tft.drawFloat(VsetCH1, 3, 125, 150, 4);
  tft.setTextColor(TFT_YELLOW, TFT_BLACK);
  tft.drawFloat(IpsetCH1, 4, 125, 180, 4);
  tft.drawFloat(InsetCH1, 4, 125, 210, 4);
  tft.setTextColor(TFT_WHITE, TFT_BLACK);
  //upDateUndLine = 1;
  underLine();
}

float checkKeys(){

  const byte MAX_CHARS = 9;
  static char inputBuffer[MAX_CHARS];
  static uint8_t inputIndex = 0;
  static float floatTotal = 0;
  static uint8_t intTotal;

  char key = keypad.getKey();

  //if (key >= '0'){
    //Serial.print("key:  ");
    //Serial.println(key);
  //}
  
  //tft.setTextDatum(TL_DATUM);
  //tft.setTextPadding(135);
  //tft.drawChar(key, 10, 150, 4);
  //tft.drawNumber(factor, 10, 170, 4);

  //if (key == 0) return;

  if (key == 'H'){
    factor++;
    factor = constrain(factor, 0, 4);
    //upDateUndLine = 1;
    underLine();
    return -1.0;
  }else if (key =='G'){
    factor--;
    factor = constrain(factor, 0, 4);
    //upDateUndLine = 1;
    underLine();
    return -1.0;
  }else if (key =='E'){
    PwSetCH1 = !PwSetCH1;               //PowerToggle Ch1
    digitalWrite(DataOut1, HIGH);
    if(PwSetCH1)Serial1.print("o");
    if(!PwSetCH1)Serial1.print("f");
    digitalWrite(DataOut1, LOW);
    return -1.0;
  }else if (key =='F'){
    PwSetCH2 = !PwSetCH2;               //PowerToggle Ch2
    return -1.0;
  }else if (key =='J'){
    ChannelSet = 0;
    //upDateUndLine = 1;
    underLine();
    return -1.0;
  }else if (key =='I'){
    ChannelSet = 1;
    //upDateUndLine = 1;
    underLine();
    return -1.0;
  }else if (key =='K'){
    return -1.0;
  }else if (key =='L'){
    digitalWrite(DataOut1, HIGH);
    Serial1.print('Y');
    digitalWrite(DataOut1, LOW);
    Serial.println("Request Data");
    return -1.0;
  }else if (key =='M'){
    //if (digitalRead(InterrSW) == 0) mode = 1;       //Enter Cal Function
    //Serial.println("why: ");
    return -1.0;
  }else if (key == 'A'){
    SetType = 0;                        //Set V
    //upDateUndLine = 1;
    underLine();
    //Serial.println("A");
    return -1.0;

  }else if (key == 'B'){
    SetType = 1;                        //Set I+
    //upDateUndLine = 1;
    underLine();
    //Serial.println("B");
    return -1.0;

  }else if (key == 'C'){
    SetType = 2;                        //Set I-
    //upDateUndLine = 1;
    underLine();
    //Serial.println("C");
    return -1.0;

  }else if (key =='D'){
    //Serial.println("D");
    //SendDataToCh1('q', DAC1m);
    //SendDataToCh1('w', DAC1b);
    return -1.0;
  }
  
  if (key == '#') //user signal that entry has finished
  {
    //Serial.println();
    //Serial.println("entry is complete");
    floatTotal = atof(inputBuffer);  //convert buffer to a float
    //Serial.println(floatTotal, 3);
    //floatTotal = 0;
    inputIndex = 0;

    tft.setTextDatum(TR_DATUM);
    tft.setTextPadding(112);
    tft.setTextColor(TFT_WHITE, TFT_BLACK);
    tft.drawString("", 150, 120, 4);

    return floatTotal; //exit the function
  }
  if (key >= '0' && key <= '9' || key == '.') //only act on numeric or '.' keys
  {
    inputBuffer[inputIndex] = key;  //put the key value in the buffer
    if (inputIndex != MAX_CHARS - 1)
    {
      inputIndex++; //increment the array
    }
    inputBuffer[inputIndex] = '\0';  //terminate the string

    tft.setTextDatum(TR_DATUM);
    tft.setTextPadding(112);
    tft.setTextColor(TFT_WHITE, TFT_BLACK);
    tft.drawString(inputBuffer, 150, 120, 4);
    //Serial.print("inputBuffer:  ");
    //Serial.println(inputBuffer);
    return -1.0;
  }

}

void underLine(){
  tft.fillRect(0, 172, 124, 4, TFT_BLACK);
  tft.fillRect(0, 202, 124, 4, TFT_BLACK);
  tft.fillRect(0, 232, 124, 4, TFT_BLACK);
  if (ChannelSet == 0)
  {
    if (SetType == 0){
      if (factor == 0)      tft.fillRect(112, 172, 12, 4, TFT_MAGENTA);
      else if (factor == 1) tft.fillRect(98, 172, 12, 4, TFT_MAGENTA);
      else if (factor == 2) tft.fillRect(84, 172, 12, 4, TFT_MAGENTA);
      else if (factor == 3) tft.fillRect(63, 172, 12, 4, TFT_MAGENTA);
      else if (factor == 4) tft.fillRect(49, 172, 12, 4, TFT_MAGENTA);
      else Error = 1;

    }else if (SetType == 1){
      if (factor == 0)      tft.fillRect(112, 202, 12, 4, TFT_MAGENTA);
      else if (factor == 1) tft.fillRect(98, 202, 12, 4, TFT_MAGENTA);
      else if (factor == 2) tft.fillRect(84, 202, 12, 4, TFT_MAGENTA);
      else if (factor == 3) tft.fillRect(70, 202, 12, 4, TFT_MAGENTA);
      else if (factor == 4) tft.fillRect(49, 202, 12, 4, TFT_MAGENTA);
      else Error = 1;

    }else if (SetType == 2){
      if (factor == 0)      tft.fillRect(112, 232, 12, 4, TFT_MAGENTA);
      else if (factor == 1) tft.fillRect(98, 232, 12, 4, TFT_MAGENTA);
      else if (factor == 2) tft.fillRect(84, 232, 12, 4, TFT_MAGENTA);
      else if (factor == 3) tft.fillRect(70, 232, 12, 4, TFT_MAGENTA);
      else if (factor == 4) tft.fillRect(49, 232, 12, 4, TFT_MAGENTA);
      else Error = 1;
    }
    else Error = 1;
  }
  //upDateUndLine = 0;
}

void FanContr(void){
  float maxTemp = temp1;
  if (maxTemp < temp2) maxTemp = temp2;
  uint16_t PWM;
  if (maxTemp <= 35.0) PWM = 0;
  else if (maxTemp > 35.0) PWM = 15.0 * maxTemp - 380.0;
  PWM = constrain(PWM, 0, 255);

  analogWrite(Fan, PWM);

  uint16_t PWMperct = PWM * 100 / 255;

  //Serial.print("PWM: ");
  //Serial.println(mode);
  //Serial.print("  perct: ");
  //Serial.println(PWMperct);

  tft.setTextDatum(TL_DATUM);
  tft.setTextPadding(60);
  tft.setTextColor(TFT_WHITE, TFT_BLACK);
  tft.drawNumber(PWMperct, 200, 0, 2);

  tft.setTextDatum(TL_DATUM);
  tft.setTextPadding(60);
  tft.setTextColor(TFT_WHITE, TFT_BLACK);
  tft.drawFloat(temp1, 1, 0, 0, 2);
  tft.drawFloat(temp2, 1, 60, 0, 2);
}

void processNumPad(float num){
  if (num == -1.0) return;
  
  if(ChannelSet == 0){                      //Set Ch1
    if (SetType == 0){                      //Set Volts
      num = constrain(num, 0.01, 25.0);
      VsetCH1 = num;
      sendVolt = 1;
    }else if(SetType == 1){                 //Set I +
      num = constrain(num, 0.000001, 5.0);
      IpsetCH1 = num;
      sendCurrP = 1;
    }else if(SetType == 2){                 //Set I +
      num = constrain(num, 0.000001, 5.0);
      InsetCH1 = num;
      sendCurrN = 1;
    }
  }
  if(ChannelSet == 1){                      //Set Ch2

  }
}

void loop() {
  if (mode == 0) LoopPSload();
  if (mode == 1) CalMode();

}
