janni0609/PsLoad/(commit log)

2024-05-20 Front Pw dist PCB
    [FrontDirstreb.kicad_pcb, FrontDirstreb.kicad_sch]
2024-05-21 OVP Handel & first capacity meas
2024-05-22 increase wire clock speed
2024-06-08 update Hardware
    Mosfet Fb and R
    Change -12V Supply
    [Boost.kicad_sch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]
2024-06-13 add hardware 2_1
    [Boost.kicad_sch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]
2024-06-16 improove gnd
    [Boost.kicad_sch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]
2024-06-17 work hardware
    [PrezisoinPowerSupply.kicad_pcb, PrezisoinPowerSupply.kicad_sch, buckLDO.kicad_sch]
2024-06-18 hardware work
    [PrezisoinPowerSupply.kicad_pcb, PrezisoinPowerSupply.kicad_sch]
2024-06-19 hardware work ##
    [PrezisoinPowerSupply.kicad_pcb, PrezisoinPowerSupply.kicad_sch]
2024-06-20 hardware relay
    [PrezisoinPowerSupply.kicad_pcb, PrezisoinPowerSupply.kicad_sch]
2024-06-22 range switch
    [PrezisoinPowerSupply.kicad_pcb, PrezisoinPowerSupply.kicad_sch]
2024-06-23 hardware Fet Range switching
    [Boost.kicad_sch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]
2024-06-23 rooting and new frontDist
    [FrontDirstreb.kicad_pcb, FrontDirstreb.kicad_sch, PrezisoinPowerSupply.kicad_pcb, PrezisoinPowerSupply.kicad_sch]
2024-06-24 finalise rooting
    [FrontDirstreb.kicad_pcb, PrezisoinPowerSupply.kicad_pcb, PrezisoinPowerSupply.kicad_sch]
2024-07-02 hardware ####
    [PrezisoinPowerSupply.kicad_pcb]
2025-02-07 new revision
    [Boost.kicad_sch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]
2025-06-20 new front dist and updates
    [FrontDirstreb.kicad_pcb, FrontDirstreb.kicad_sch, PrezisoinPowerSupply.kicad_pcb, PrezisoinPowerSupply.kicad_sch, buckLDO.kicad_sch]
2026-05-31 folder cleanup and removed hardware
    [BeeperAddOn.kicad_pcb, BeeperAddOn.kicad_sch, Boost.kicad_sch, FrontDirstreb.kicad_pcb, FrontDirstreb.kicad_sch, MCU&ISO.kicad_sch, PowerDel.kicad_sch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]
